dsatizabal/cpuy/caravel_board/hardware/breakout/_archive/caravel_breakout_QFN/gerbers/caravel_breakout_QFN-NPTH-drl_map.dxf

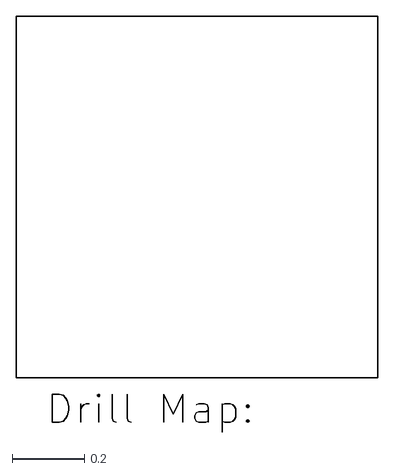
[picture p2: CAD file, 2025-09-26, an earlier design]
caravel_board/hardware/breakout/_archive/caravel_breakout_QFN/gerbers/caravel_breakout_QFN-NPTH-drl_map.dxf
1.00 x 1.15
