dsatizabal/cpuy/caravel_board/hardware/breakout/_archive/caravel_breakout_v1/gerbers/Caravel_breakout-drl_map.dxf

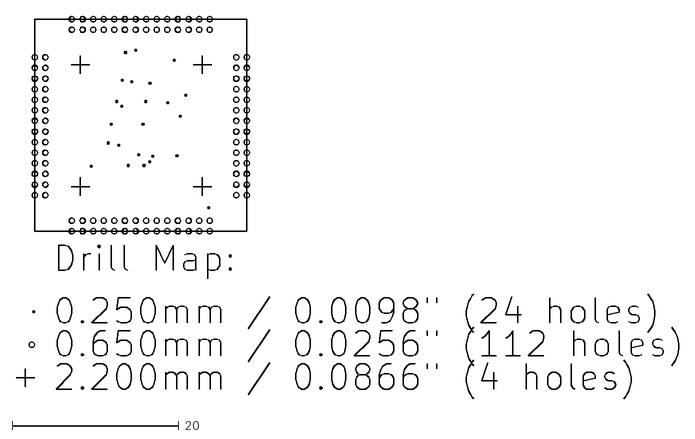
[picture p3: CAD file, 2025-09-26, an earlier design]
caravel_board/hardware/breakout/_archive/caravel_breakout_v1/gerbers/Caravel_breakout-drl_map.dxf
79.4 x 45.8
