dsatizabal/cpuy/caravel_board/hardware/breakout/_archive/caravel_breakout_v1/TC2030-IDC-NL/TC2030-IDC-NL.step

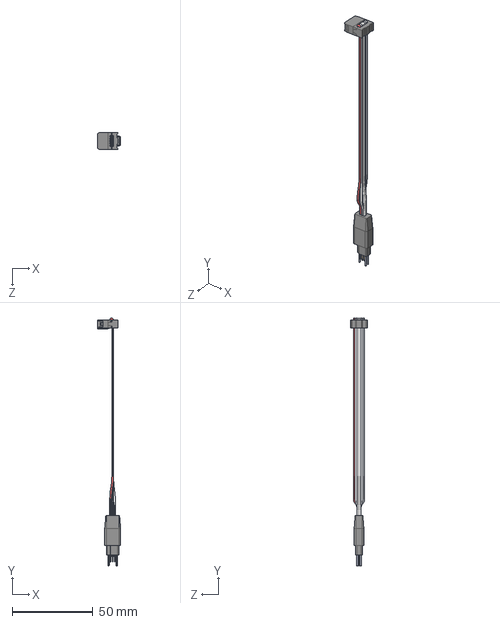
[picture p4: CAD file, 2025-09-26, an earlier design]
caravel_board/hardware/breakout/_archive/caravel_breakout_v1/TC2030-IDC-NL/TC2030-IDC-NL.step
14.5 x 153.6 x 10.7 mm
