dsatizabal/cpuy/caravel_board/hardware/breakout/_archive/caravel_breakout_QFN/gerbers/caravel_breakout_QFN-PTH-drl_map.dxf

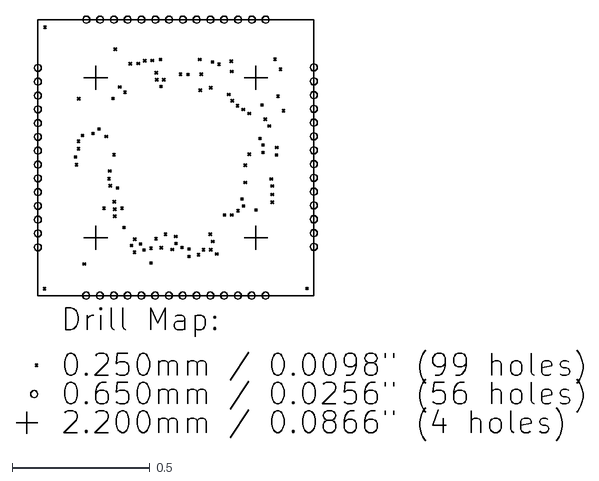
[picture p5: CAD file, 2025-09-26, an earlier design]
caravel_board/hardware/breakout/_archive/caravel_breakout_QFN/gerbers/caravel_breakout_QFN-PTH-drl_map.dxf
2.05 x 1.54
