dsatizabal/cpuy/verilog/instructions/Processor instructions set.xlsx

Type | Instruction | OpCode |  |  |  |  |  |  |  | Op1 |  |  |  |  |  |  |  | Op2 |  |  |  |  |  |  |  | Opcode DEC
Instructions with operands | MovMW | 1 | 0 | 0 | 0 | 0 | 0 | 0 | O | A | A | A | A | A | A | A | A | - | - | - | - | - | - | - | - | 128 - 129
 | MovWM | 1 | 0 | 0 | 0 | 0 | 0 | 1 | O | A | A | A | A | A | A | A | A | - | - | - | - | - | - | - | - | 130 - 131
 | MovLW | 1 | 0 | 0 | 0 | 0 | 1 | 0 | O | L | L | L | L | L | L | L | L | - | - | - | - | - | - | - | - | 132 - 133
 | MovLM | 1 | 0 | 0 | 0 | 0 | 1 | 1 | O | L | L | L | L | L | L | L | L | A | A | A | A | A | A | A | A | 134 - 135
 | AddLW | 1 | 0 | 0 | 0 | 1 | 0 | 0 | O | L | L | L | L | L | L | L | L | - | - | - | - | - | - | - | - | 136 - 137
 | AddMW | 1 | 0 | 0 | 0 | 1 | 0 | 1 | O | A | A | A | A | A | A | A | A | - | - | - | - | - | - | - | - | 138 - 139
 | SubLW | 1 | 0 | 0 | 0 | 1 | 1 | 0 | O | L | L | L | L | L | L | L | L | - | - | - | - | - | - | - | - | 140 - 141
 | SubMW | 1 | 0 | 0 | 0 | 1 | 1 | 1 | O | A | A | A | A | A | A | A | A | - | - | - | - | - | - | - | - | 142 - 143
 | MulLW | 1 | 0 | 0 | 1 | 0 | 0 | 0 | O | L | L | L | L | L | L | L | L | A | A | A | A | A | A | A | A | 144 - 145
 | MulMW | 1 | 0 | 0 | 1 | 0 | 0 | 1 | O | A1 | A1 | A1 | A1 | A1 | A1 | A1 | A1 | A2 | A2 | A2 | A2 | A2 | A2 | A2 | A2 | 146 - 147
 | AndLW | 1 | 0 | 0 | 1 | 0 | 1 | 0 | O | L | L | L | L | L | L | L | L | - | - | - | - | - | - | - | - | 148 - 149
 | AndMW | 1 | 0 | 0 | 1 | 0 | 1 | 1 | O | A | A | A | A | A | A | A | A | - | - | - | - | - | - | - | - | 150 - 151
 | OrLW | 1 | 0 | 0 | 1 | 1 | 0 | 0 | O | L | L | L | L | L | L | L | L | - | - | - | - | - | - | - | - | 152 - 153
 | OrMW | 1 | 0 | 0 | 1 | 1 | 0 | 1 | O | A | A | A | A | A | A | A | A | - | - | - | - | - | - | - | - | 154 - 155
 | XorLW | 1 | 0 | 0 | 1 | 1 | 1 | 0 | O | L | L | L | L | L | L | L | L | - | - | - | - | - | - | - | - | 156 - 157
 | XorMW | 1 | 0 | 0 | 1 | 1 | 1 | 1 | O | A | A | A | A | A | A | A | A | - | - | - | - | - | - | - | - | 158 - 159
 | XchWM | 1 | 0 | 1 | 0 | 0 | 0 | 0 | O | A | A | A | A | A | A | A | A | - | - | - | - | - | - | - | - | 160 - 161
 | Jmp | 1 | 0 | 1 | 0 | 0 | 0 | 1 | O | A | A | A | A | A | A | A | A | A | A | A | A | A | A | A | A | 162 - 163
 | JmpC | 1 | 0 | 1 | 0 | 0 | 1 | 0 | O | A | A | A | A | A | A | A | A | A | A | A | A | A | A | A | A | 164 - 165
 | JmpZ | 1 | 0 | 1 | 0 | 0 | 1 | 1 | O | A | A | A | A | A | A | A | A | A | A | A | A | A | A | A | A | 166 - 167
 | JmpS | 1 | 0 | 1 | 0 | 1 | 0 | 0 | O | A | A | A | A | A | A | A | A | A | A | A | A | A | A | A | A | 168 - 169
 | Call | 1 | 0 | 1 | 0 | 1 | 0 | 1 | O | A | A | A | A | A | A | A | A | A | A | A | A | A | A | A | A | 170 - 171
 | UNUSED | 1 | 0 | 1 | 0 | 1 | 1 | 0 | O | - | - | - | - | - | - | - | - | - | - | - | - | - | - | - | - | 172 - 173
 | UNUSED | 1 | 0 | 1 | 0 | 1 | 1 | 1 | O | - | - | - | - | - | - | - | - | - | - | - | - | - | - | - | - | 174 - 175
 | UNUSED | 1 | 0 | 1 | 1 | 0 | 0 | 0 | O | - | - | - | - | - | - | - | - | - | - | - | - | - | - | - | - | 176 - 177
 | UNUSED | 1 | 0 | 1 | 1 | 0 | 0 | 1 | O | - | - | - | - | - | - | - | - | - | - | - | - | - | - | - | - | 178 - 179
 | UNUSED | 1 | 0 | 1 | 1 | 0 | 1 | 0 | O | - | - | - | - | - | - | - | - | - | - | - | - | - | - | - | - | 180 - 181
 | UNUSED | 1 | 0 | 1 | 1 | 0 | 1 | 1 | O | - | - | - | - | - | - | - | - | - | - | - | - | - | - | - | - | 182 - 183
 | UNUSED | 1 | 0 | 1 | 1 | 1 | 0 | 0 | O | - | - | - | - | - | - | - | - | - | - | - | - | - | - | - | - | 184 - 185
 | UNUSED | 1 | 0 | 1 | 1 | 1 | 0 | 1 | O | - | - | - | - | - | - | - | - | - | - | - | - | - | - | - | - | 186 - 187
 | UNUSED | 1 | 0 | 1 | 1 | 1 | 1 | 0 | O | - | - | - | - | - | - | - | - | - | - | - | - | - | - | - | - | 188 - 189
 | UNUSED | 1 | 0 | 1 | 1 | 1 | 1 | 1 | O | - | - | - | - | - | - | - | - | - | - | - | - | - | - | - | - | 190 - 191
 | UNUSED | 1 | 1 | 0 | 0 | 0 | 0 | 0 | O | - | - | - | - | - | - | - | - | - | - | - | - | - | - | - | - | 192 - 193
 | UNUSED | 1 | 1 | 0 | 0 | 0 | 0 | 1 | O | - | - | - | - | - | - | - | - | - | - | - | - | - | - | - | - | 194 - 195
 | UNUSED | 1 | 1 | 0 | 0 | 0 | 1 | 0 | O | - | - | - | - | - | - | - | - | - | - | - | - | - | - | - | - | 196 - 197
 | UNUSED | 1 | 1 | 0 | 0 | 0 | 1 | 1 | O | - | - | - | - | - | - | - | - | - | - | - | - | - | - | - | - | 198 - 199
 | UNUSED | 1 | 1 | 0 | 0 | 1 | 0 | 0 | O | - | - | - | - | - | - | - | - | - | - | - | - | - | - | - | - | 200 - 201
 | UNUSED | 1 | 1 | 0 | 0 | 1 | 0 | 1 | O | - | - | - | - | - | - | - | - | - | - | - | - | - | - | - | - | 202 - 203
 | UNUSED | 1 | 1 | 0 | 0 | 1 | 1 | 0 | O | - | - | - | - | - | - | - | - | - | - | - | - | - | - | - | - | 204 - 205
 | UNUSED | 1 | 1 | 0 | 0 | 1 | 1 | 1 | O | - | - | - | - | - | - | - | - | - | - | - | - | - | - | - | - | 206 - 207
 | UNUSED | 1 | 1 | 0 | 1 | 0 | 0 | 0 | O | - | - | - | - | - | - | - | - | - | - | - | - | - | - | - | - | 208 - 209
 | UNUSED | 1 | 1 | 0 | 1 | 0 | 0 | 1 | O | - | - | - | - | - | - | - | - | - | - | - | - | - | - | - | - | 210 - 211
 | UNUSED | 1 | 1 | 0 | 1 | 0 | 1 | 0 | O | - | - | - | - | - | - | - | - | - | - | - | - | - | - | - | - | 212 - 213
 | UNUSED | 1 | 1 | 0 | 1 | 0 | 1 | 1 | O | - | - | - | - | - | - | - | - | - | - | - | - | - | - | - | - | 214 - 215
 | UNUSED | 1 | 1 | 0 | 1 | 1 | 0 | 0 | O | - | - | - | - | - | - | - | - | - | - | - | - | - | - | - | - | 216 - 217
 | UNUSED | 1 | 1 | 0 | 1 | 1 | 0 | 1 | O | - | - | - | - | - | - | - | - | - | - | - | - | - | - | - | - | 218 - 219
 | UNUSED | 1 | 1 | 0 | 1 | 1 | 1 | 0 | O | - | - | - | - | - | - | - | - | - | - | - | - | - | - | - | - | 220 - 221
 | UNUSED | 1 | 1 | 0 | 1 | 1 | 1 | 1 | O | - | - | - | - | - | - | - | - | - | - | - | - | - | - | - | - | 222 - 223
 | Tbjc (bit 0) | 1 | 1 | 1 | 0 | 0 | 0 | 0 | O | A | A | A | A | A | A | A | A | A | A | A | A | A | A | A | A | 224 - 225
 | Tbjc (bit 1) | 1 | 1 | 1 | 0 | 0 | 0 | 1 | O | A | A | A | A | A | A | A | A | A | A | A | A | A | A | A | A | 226 - 227
 | Tbjc (bit 2) | 1 | 1 | 1 | 0 | 0 | 1 | 0 | O | A | A | A | A | A | A | A | A | A | A | A | A | A | A | A | A | 228 - 229
 | Tbjc (bit 3) | 1 | 1 | 1 | 0 | 0 | 1 | 1 | O | A | A | A | A | A | A | A | A | A | A | A | A | A | A | A | A | 230 - 231
 | Tbjc (bit 4) | 1 | 1 | 1 | 0 | 1 | 0 | 0 | O | A | A | A | A | A | A | A | A | A | A | A | A | A | A | A | A | 232 - 233
 | Tbjc (bit 5) | 1 | 1 | 1 | 0 | 1 | 0 | 1 | O | A | A | A | A | A | A | A | A | A | A | A | A | A | A | A | A | 234 - 235
 | Tbjc (bit 6) | 1 | 1 | 1 | 0 | 1 | 1 | 0 | O | A | A | A | A | A | A | A | A | A | A | A | A | A | A | A | A | 236 - 237
 | Tbjc (bit 7) | 1 | 1 | 1 | 0 | 1 | 1 | 1 | O | A | A | A | A | A | A | A | A | A | A | A | A | A | A | A | A | 238 - 239
 | Tbjs (bit 0) | 1 | 1 | 1 | 1 | 0 | 0 | 0 | O | A | A | A | A | A | A | A | A | A | A | A | A | A | A | A | A | 240 - 241
 | Tbjs (bit 1) | 1 | 1 | 1 | 1 | 0 | 0 | 1 | O | A | A | A | A | A | A | A | A | A | A | A | A | A | A | A | A | 242 - 243
 | Tbjs (bit 2) | 1 | 1 | 1 | 1 | 0 | 1 | 0 | O | A | A | A | A | A | A | A | A | A | A | A | A | A | A | A | A | 244 - 245
 | Tbjs (bit 3) | 1 | 1 | 1 | 1 | 0 | 1 | 1 | O | A | A | A | A | A | A | A | A | A | A | A | A | A | A | A | A | 246 - 247
 | Tbjs (bit 4) | 1 | 1 | 1 | 1 | 1 | 0 | 0 | O | A | A | A | A | A | A | A | A | A | A | A | A | A | A | A | A | 248 - 249
 | Tbjs (bit 5) | 1 | 1 | 1 | 1 | 1 | 0 | 1 | O | A | A | A | A | A | A | A | A | A | A | A | A | A | A | A | A | 250 - 251
 | Tbjs (bit 6) | 1 | 1 | 1 | 1 | 1 | 1 | 0 | O | A | A | A | A | A | A | A | A | A | A | A | A | A | A | A | A | 252 - 253
 | Tbjs (bit 7) | 1 | 1 | 1 | 1 | 1 | 1 | 1 | O | A | A | A | A | A | A | A | A | A | A | A | A | A | A | A | A | 254 - 255
Instructions without operands | NOP | 0 | 0 | 0 | 0 | 0 | 0 | 0 | 0 | - | - | - | - | - | - | - | - | - | - | - | - | - | - | - | - | 0
 | Dec | 0 | 0 | 0 | 0 | 0 | 0 | 0 | 1 | - | - | - | - | - | - | - | - | - | - | - | - | - | - | - | - | 1
 | Inc | 0 | 0 | 0 | 0 | 0 | 0 | 1 | 0 | - | - | - | - | - | - | - | - | - | - | - | - | - | - | - | - | 2
 | Not | 0 | 0 | 0 | 0 | 0 | 0 | 1 | 1 | - | - | - | - | - | - | - | - | - | - | - | - | - | - | - | - | 3
 | SetC | 0 | 0 | 0 | 0 | 0 | 1 | 0 | 0 | - | - | - | - | - | - | - | - | - | - | - | - | - | - | - | - | 4
 | ClrC | 0 | 0 | 0 | 0 | 0 | 1 | 0 | 1 | - | - | - | - | - | - | - | - | - | - | - | - | - | - | - | - | 5
 | RL | 0 | 0 | 0 | 0 | 0 | 1 | 1 | 0 | - | - | - | - | - | - | - | - | - | - | - | - | - | - | - | - | 6
 | RR | 0 | 0 | 0 | 0 | 0 | 1 | 1 | 1 | - | - | - | - | - | - | - | - | - | - | - | - | - | - | - | - | 7
 | RLC | 0 | 0 | 0 | 0 | 1 | 0 | 0 | 0 | - | - | - | - | - | - | - | - | - | - | - | - | - | - | - | - | 8
 | RRC | 0 | 0 | 0 | 0 | 1 | 0 | 0 | 1 | - | - | - | - | - | - | - | - | - | - | - | - | - | - | - | - | 9
 | Swap | 0 | 0 | 0 | 0 | 1 | 0 | 1 | 0 | - | - | - | - | - | - | - | - | - | - | - | - | - | - | - | - | 10
 | UNUSED | 0 | 0 | 0 | 0 | 1 | 0 | 1 | 1 | - | - | - | - | - | - | - | - | - | - | - | - | - | - | - | - | 11
 | UNUSED | 0 | 0 | 0 | 0 | 1 | 1 | 0 | 0 | - | - | - | - | - | - | - | - | - | - | - | - | - | - | - | - | 12
 | UNUSED | 0 | 0 | 0 | 0 | 1 | 1 | 0 | 1 | - | - | - | - | - | - | - | - | - | - | - | - | - | - | - | - | 13
 | UNUSED | 0 | 0 | 0 | 0 | 1 | 1 | 1 | 0 | - | - | - | - | - | - | - | - | - | - | - | - | - | - | - | - | 14
 | UNUSED | 0 | 0 | 0 | 0 | 1 | 1 | 1 | 1 | - | - | - | - | - | - | - | - | - | - | - | - | - | - | - | - | 15
 | UNUSED | 0 | 0 | 0 | 1 | 0 | 0 | 0 | 0 | - | - | - | - | - | - | - | - | - | - | - | - | - | - | - | - | 16
 | UNUSED | 0 | 0 | 0 | 1 | 0 | 0 | 0 | 1 | - | - | - | - | - | - | - | - | - | - | - | - | - | - | - | - | 17
 | UNUSED | 0 | 0 | 0 | 1 | 0 | 0 | 1 | 0 | - | - | - | - | - | - | - | - | - | - | - | - | - | - | - | - | 18
 | UNUSED | 0 | 0 | 0 | 1 | 0 | 0 | 1 | 1 | - | - | - | - | - | - | - | - | - | - | - | - | - | - | - | - | 19
 | UNUSED | 0 | 0 | 0 | 1 | 0 | 1 | 0 | 0 | - | - | - | - | - | - | - | - | - | - | - | - | - | - | - | - | 20
 | UNUSED | 0 | 0 | 0 | 1 | 0 | 1 | 0 | 1 | - | - | - | - | - | - | - | - | - | - | - | - | - | - | - | - | 21
 | UNUSED | 0 | 0 | 0 | 1 | 0 | 1 | 1 | 0 | - | - | - | - | - | - | - | - | - | - | - | - | - | - | - | - | 22
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
 | UNUSED | 0 | 1 | 1 | 1 | 1 | 1 | 1 | 0 | - | - | - | - | - | - | - | - | - | - | - | - | - | - | - | - | 126
 | UNUSED | 0 | 1 | 1 | 1 | 1 | 1 | 1 | 1 | - | - | - | - | - | - | - | - | - | - | - | - | - | - | - | - | 127
