dsatizabal/cpuy/docs/cpuy-diagram-1.pdf

# top_design_mux mux control

LA

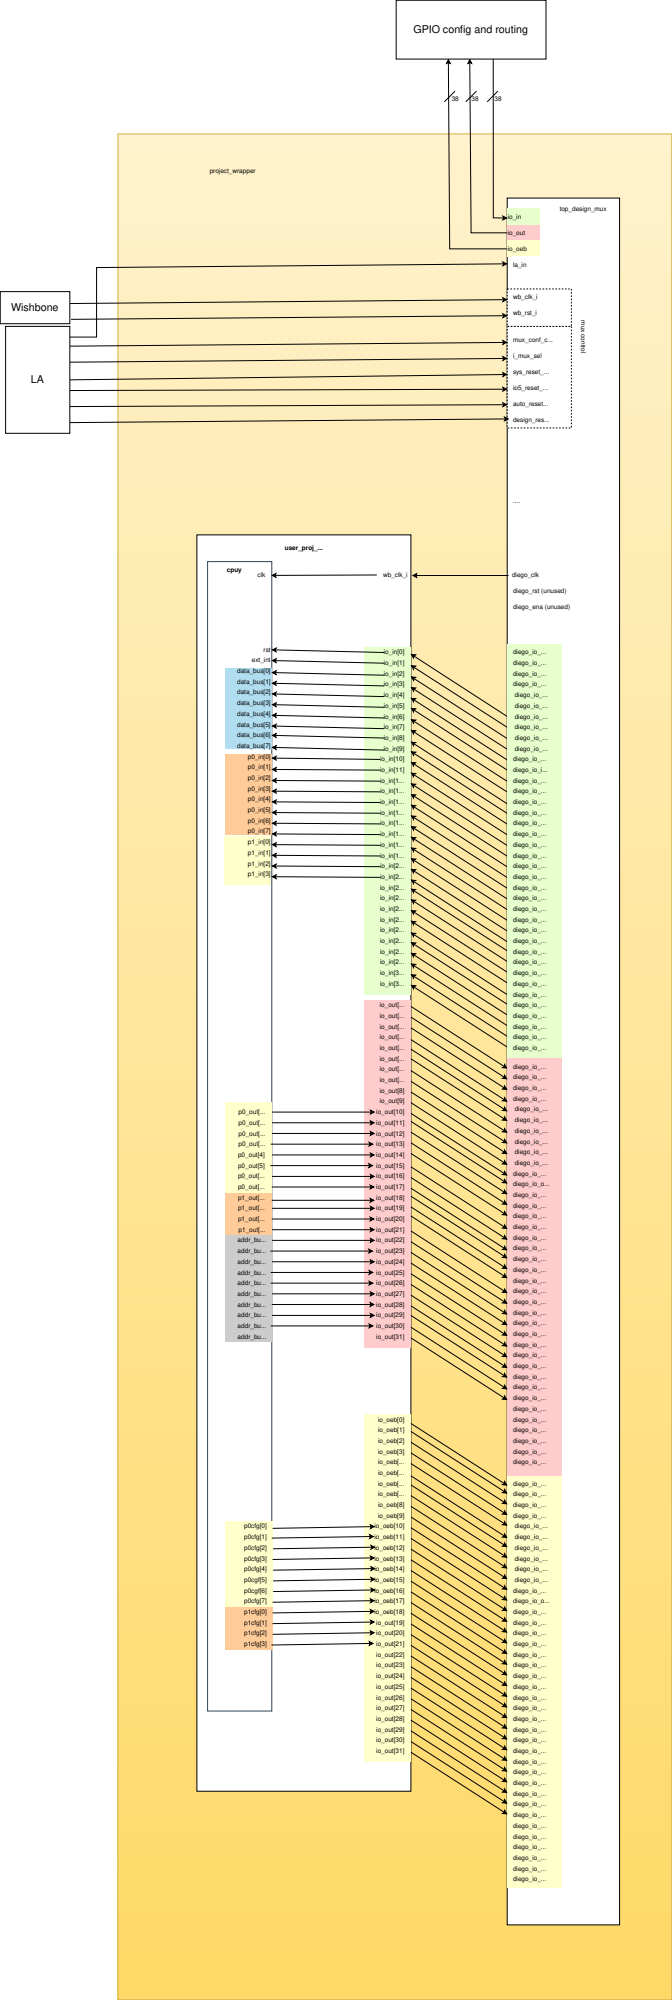
[picture p6: page 1]
io_out; io_oeb; diego_clk; diego_rst (unused); clk; wb_clk_i; ext_int; data_bus[0]; cpuy; user_proj_...; project_wrapper; design_res...; auto_reset...; io5_reset_...; sys_reset_...; i_mux_sel; mux_conf_c...; rst; data_bus[1]; data_bus[2]; data_bus[3]; data_bus[4]; data_bus[5]; data_bus[6]; data_bus[7]; io_out[...; io_out[8]; io_out[9]; io_out[10]; io_out[11]; io_out[12]; io_out[13]; io_out[14]; io_out[15]; io_out[16]; io_out[17]; io_out[18]; io_out[19]; io_out[20]; io_out[21]; io_out[22]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

GPIO config and routing
