dsatizabal/cpuy/docs/cpuy-diagram-2.pdf

# ROM

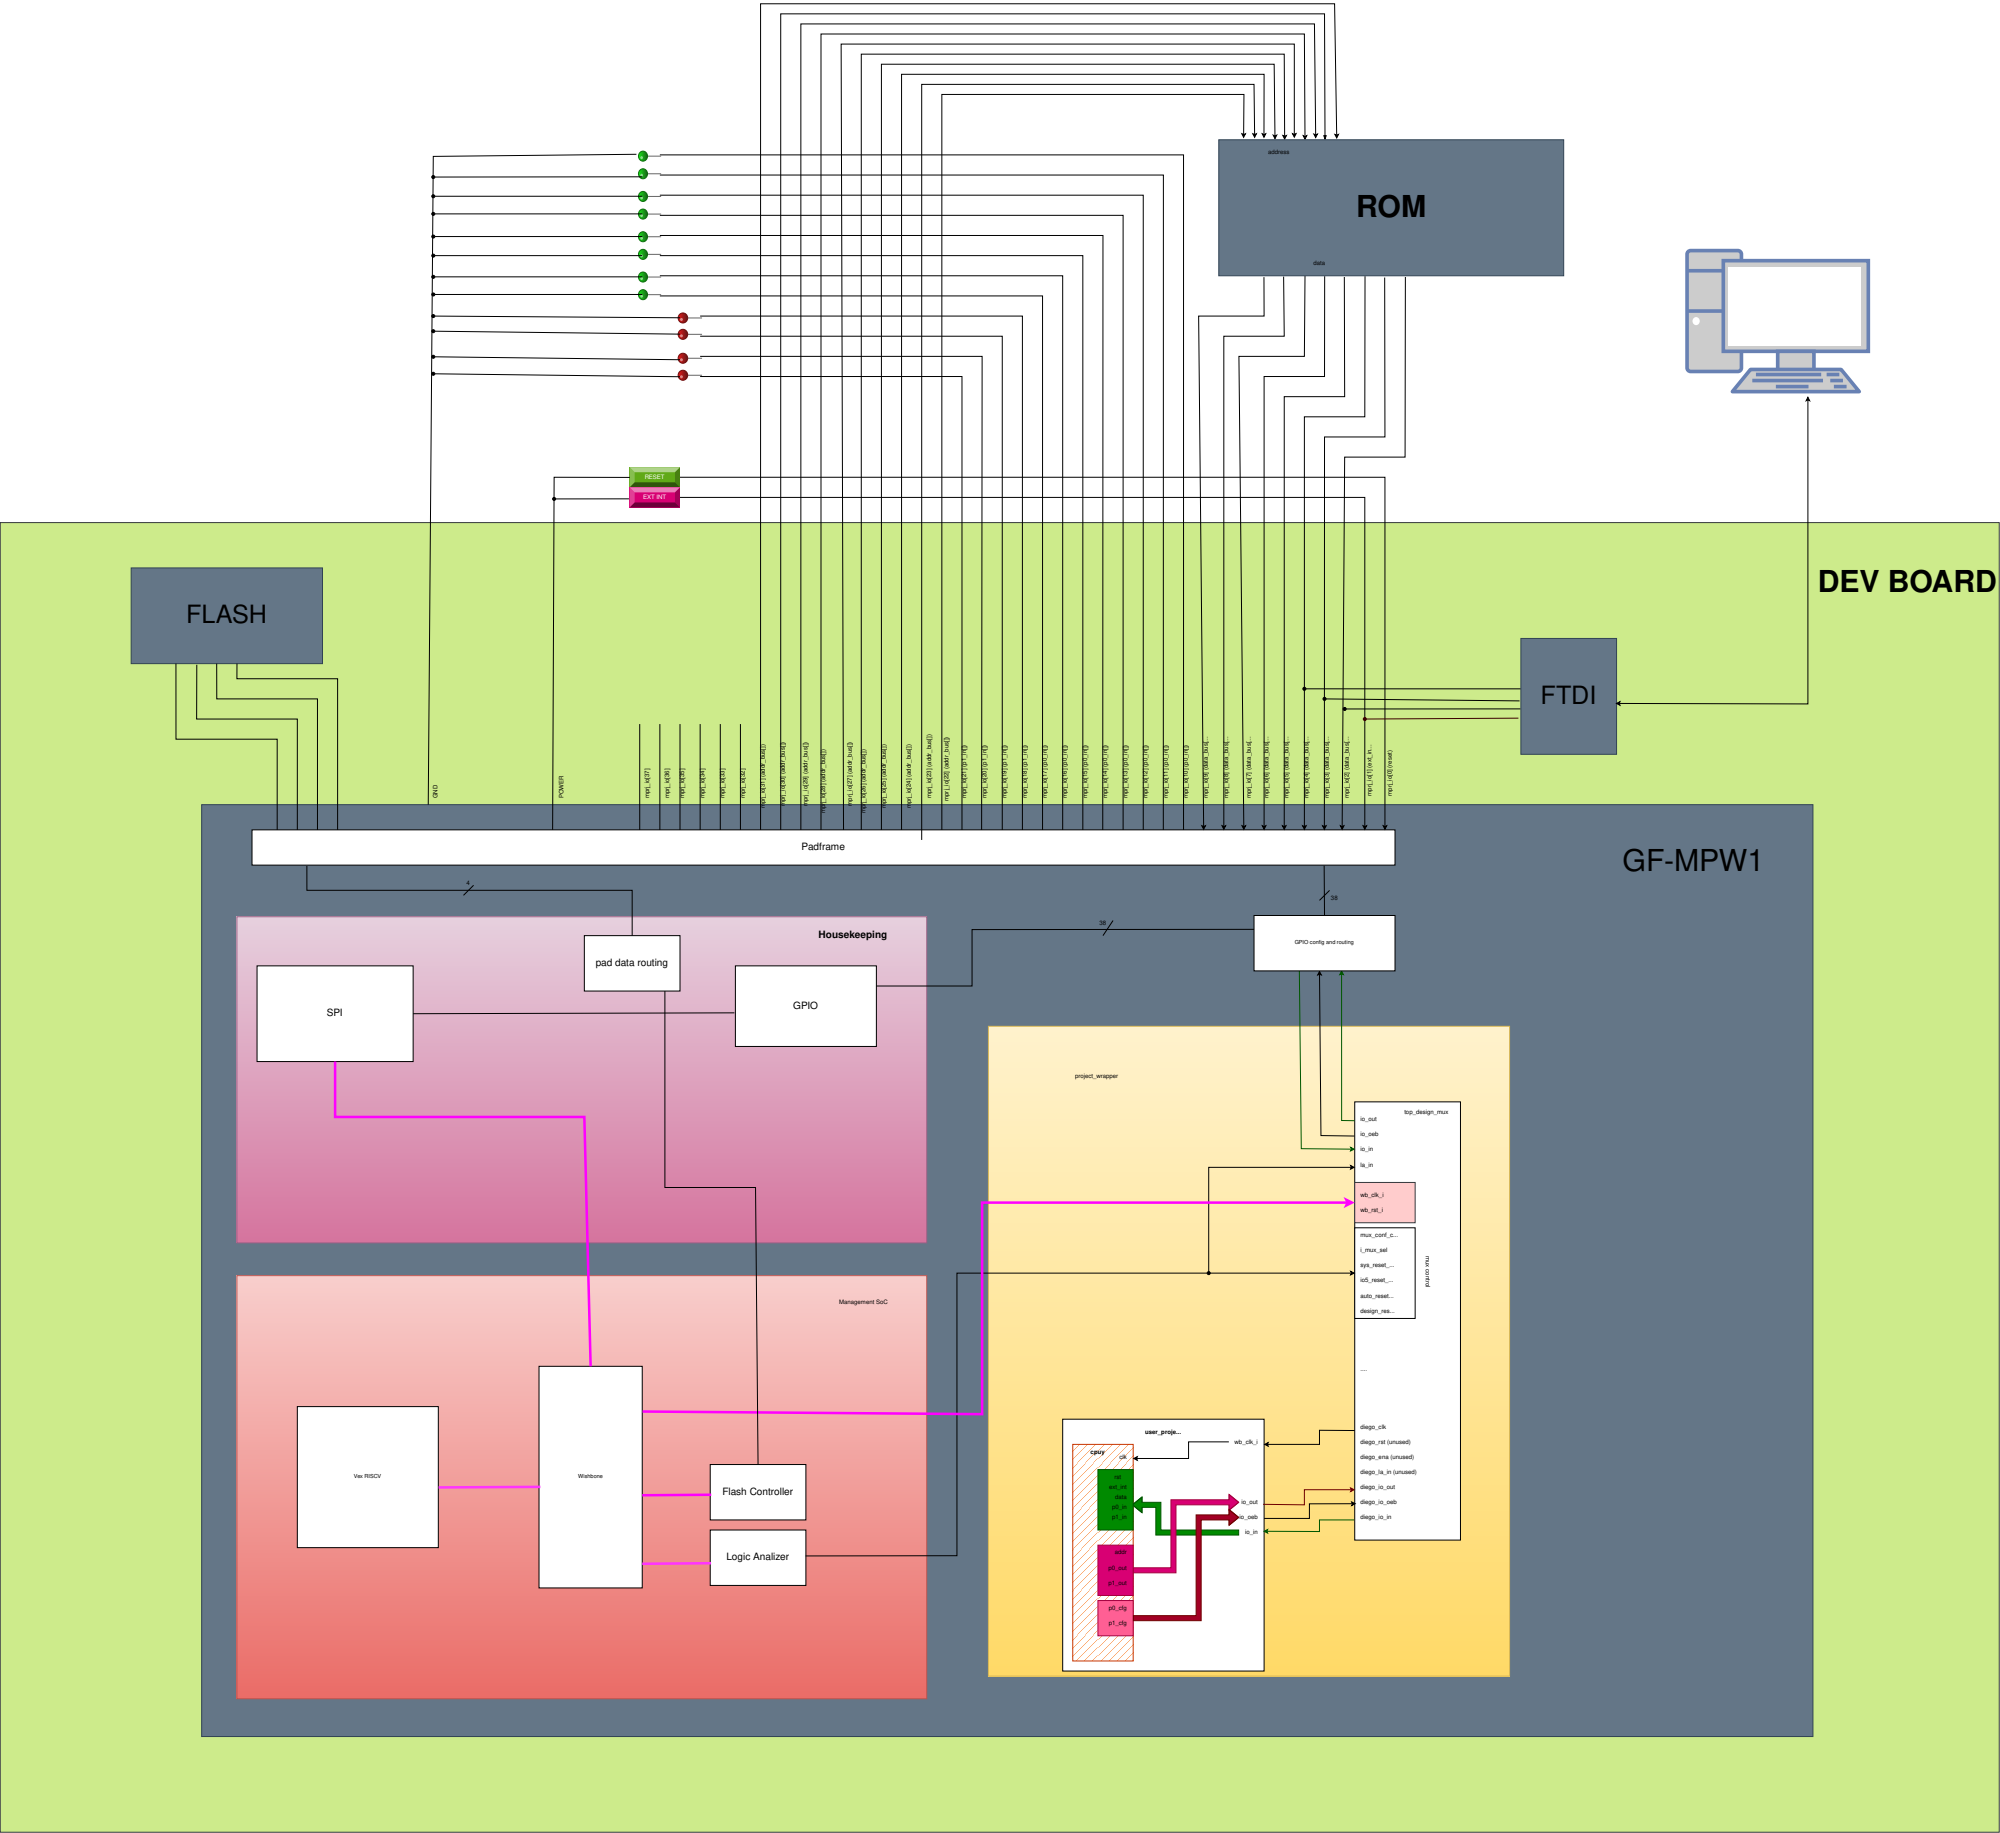
[picture p7: page 1]
io_out; io_oeb; diego_clk; diego_rst (unused); diego_ena (unused); diego_io_out; diego_io_oeb; diego_io_in; diego_la_in (unused); wb_clk_i; clk; ext_int; data; addr; p0_out; p1_out; p0_cfg; p1_cfg; cpuy; user_proje...; project_wrapper; Padframe; design_res...; auto_reset...; io5_reset_...; sys_reset_...; i_mux_sel; mux_conf_c...; wb_rst_i; Logic Analizer; top_design_mux mux control; Vex RISCV; Wishbone; Management SoC; mprj_io[1] (ext_in...; mprj_io[0] (reset); GF-MPW1; mprj_io[21] (p1_in[])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

GPIO config and routing

pad data routing
