dsatizabal/cpuy/caravel_board/hardware/development/caravel-dev-v5-M.2/caravel-dev-v5-M.2.kicad_pcb

## KiCad design caravel_board/hardware/development/caravel-dev-v5-M.2/caravel-dev-v5-M.2.kicad_pcb (2025-09-26, last stored version)

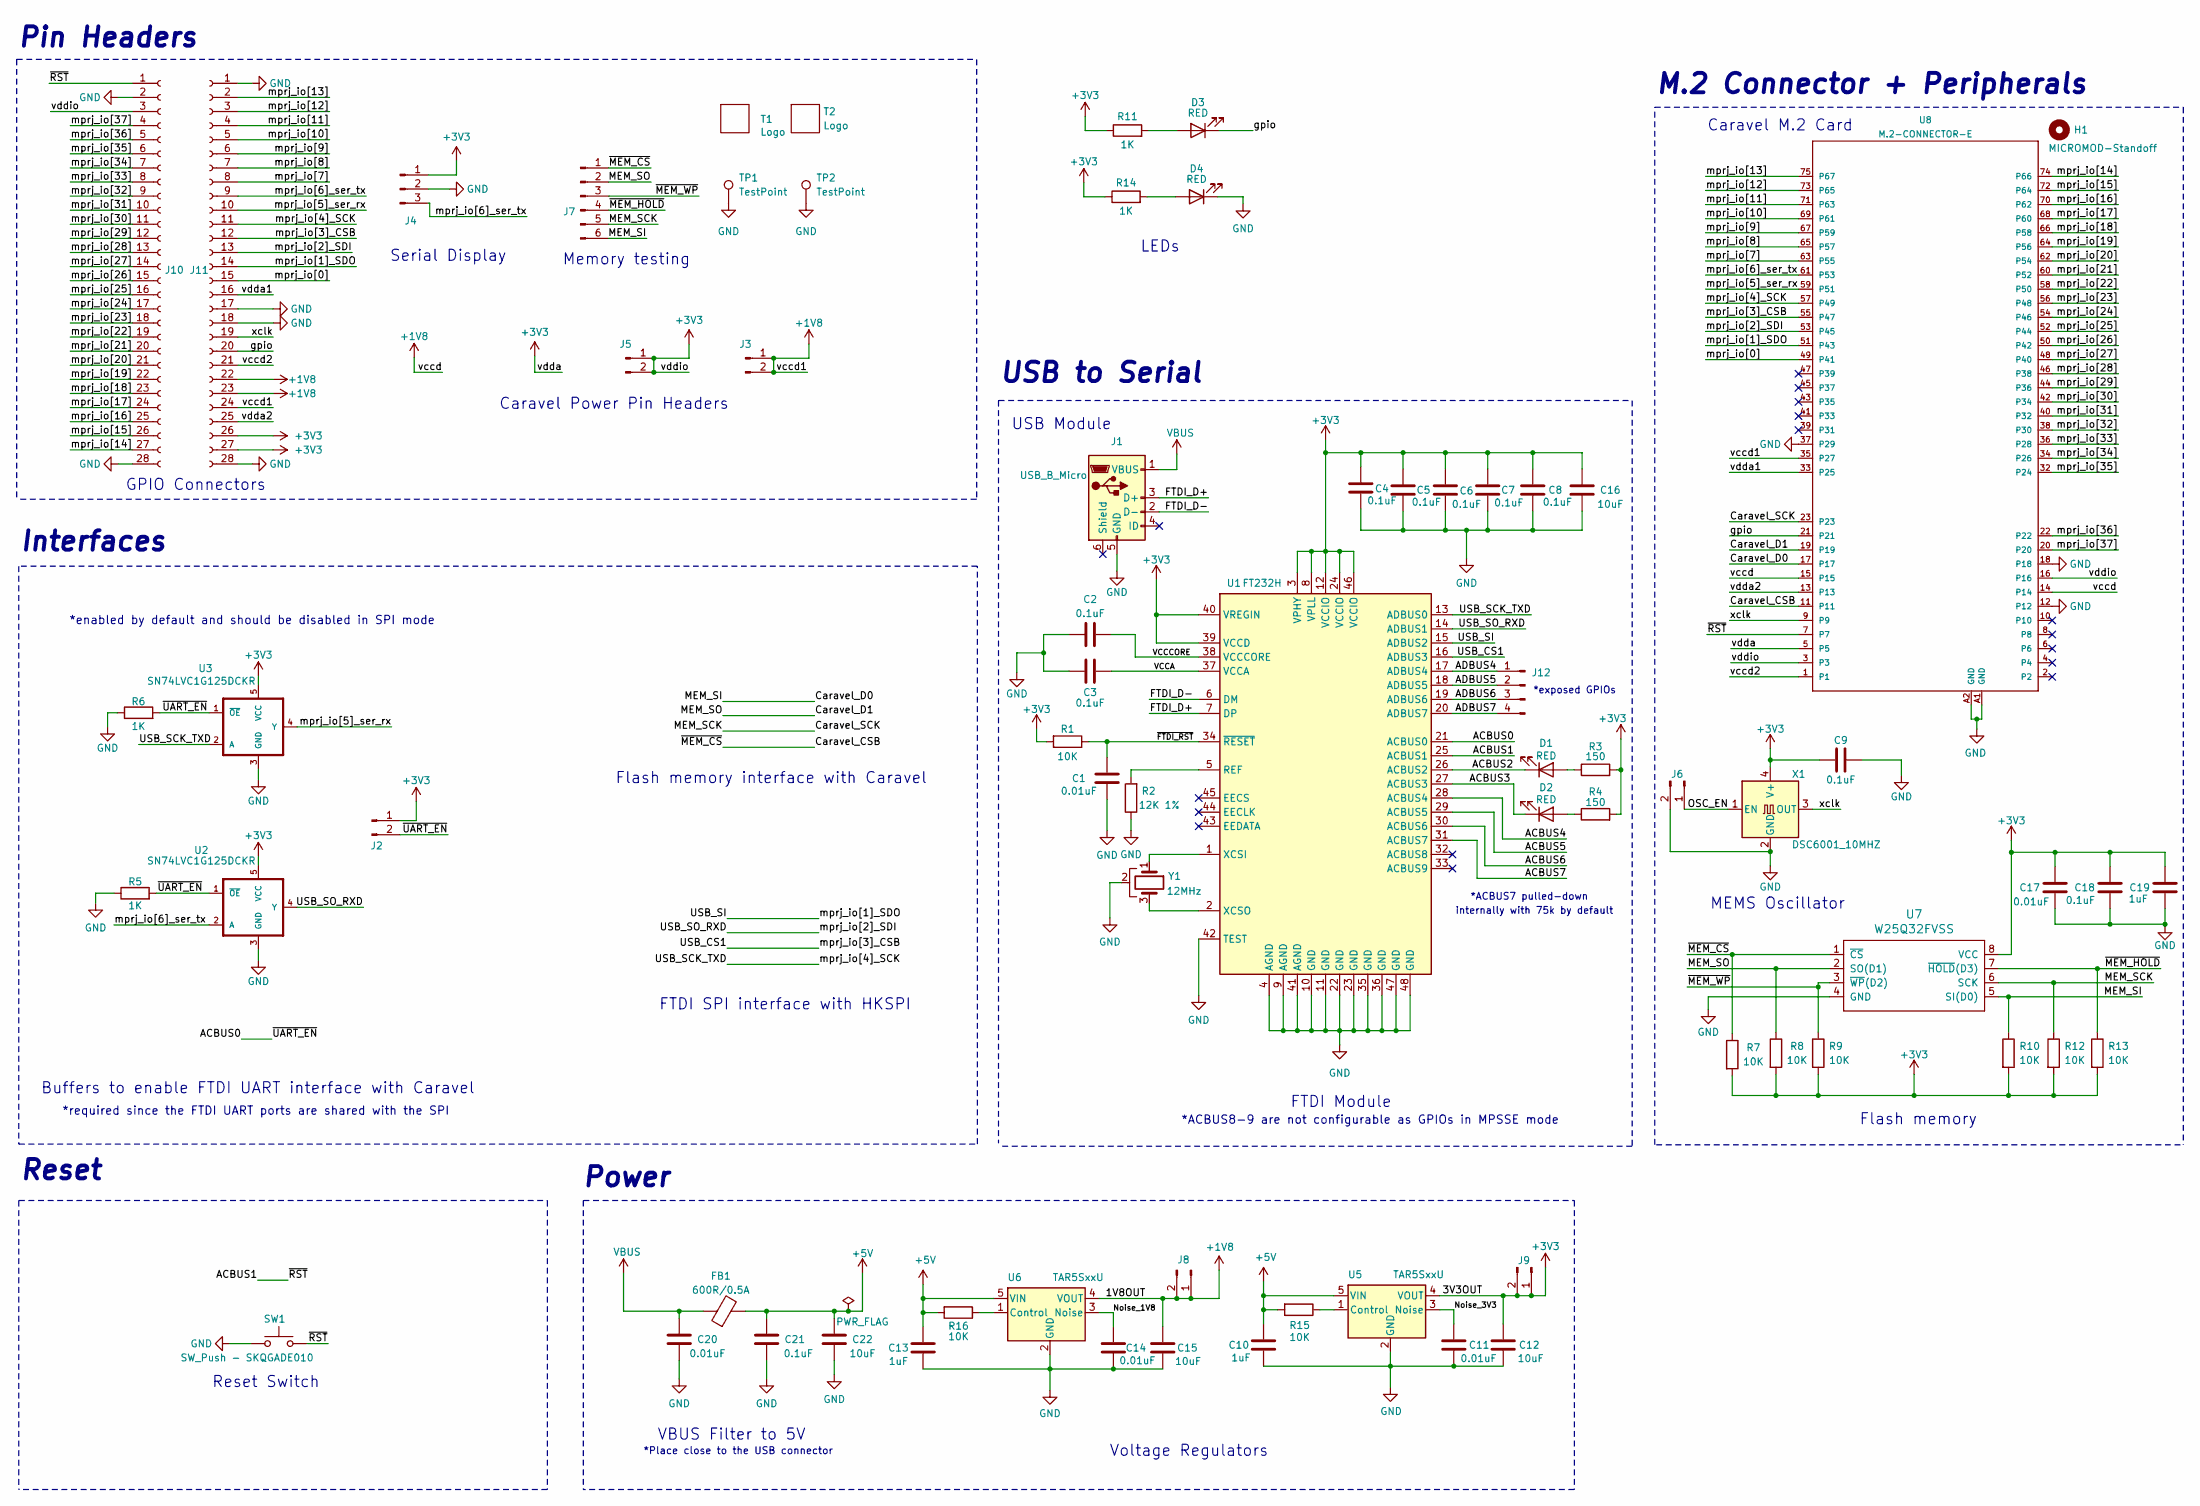
[picture p8: schematic caravel-dev-v5-M.2.kicad_sch, Caravel 3.3V Development Board]

Parts:
C1, C11, C14, C17, C20: 0.01uF; C_0805_2012Metric; Part # C0805C103K5RAC7411
C2, C3, C4, C5, C6, C7, C8, C9, C18, C21: 0.1uF; C_0805_2012Metric; Part # C0805C104K5RAC7411
C10, C13, C19: 1uF; C_0805_2012Metric; Part # 885012207103
C12, C15, C16, C22: 10uF; C_0805_2012Metric; Part # CL21B106KAYQNNE
D1, D2, D3, D4: RED; LED_1206_3216Metric; Part # LTST-C230KRKT
FB1: 600R/0.5A; L_0805_2012Metric; Part # 7427920415
H1: MICROMOD-Standoff; MicroMod-Standoff
J1: USB_B_Micro; FCI_10118193-0001LF; Part # 10118193-0001LF
J2, J3, J5, J6, J8, J9: Conn_01x02_Pin; PinHeader_1x02_P2.54mm_Vertical
J4: Conn_01x03_Pin; PinHeader_1x03_P2.54mm_Vertical
J7: Conn_01x06_Pin; PinHeader_1x06_P2.54mm_Vertical
J10, J11: Conn_01x28_Pin; PinHeader_1x28_P2.54mm_Vertical
J12: Conn_01x04_Pin; PinHeader_1x04_P2.54mm_Vertical
R1, R7, R8, R9, R10, R12, R13, R15, R16: 10K; R_0805_2012Metric; Part # RC0805FR-0710KL
R2: 12K 1%; R_0805_2012Metric; Part # RMCF0805FT12K0
R3, R4: 150; R_0805_2012Metric; Part # RNCP0805FTD150R
R5, R6, R11, R14: 1K; R_0805_2012Metric; Part # RC0805FR-071KL
SW1: SW_Push - SKQGADE010; SW4-SMD-5.2X5.2X1.5MM
T1: Logo; logo_large
T2: Logo; ef_logo_large
TP1, TP2: TestPoint; TestPoint_Bridge_Pitch2.54mm_Drill1.0mm
U1: FT232H; QFN-48-1EP_8x8mm_P0.5mm_EP6.2x6.2mm; Part # FT232H
U2, U3: SN74LVC1G125DCKR; SOT65P210X110-5N; Part # SN74LVC1G125DCKR
U5: TAR5SxxU; SOT-353F; Part # TAR5S33UTE85LF
U6: TAR5SxxU; SOT-353F; Part # TAR5S18U-TE85L-F
U7: W25Q32FVSS; SOIC127P790X216-8N; Part # W25Q32JVSSIQ
U8: M.2-CONNECTOR-E
X1: DSC6001_10MHZ; DSC6001JE1A-010.0000; Part # DSC6001JI1B
Y1: 12MHz; CSTNE12M0GH5L000R0; Part # CSTNE12M0GH5L000R0

Connections:
+1V8: C15.2, J3.1, J3.2, J8.1, J8.2, J11.22, J11.23, J11.24, U6.4 (VOUT), U8.14, U8.15, U8.35 (P27)
+3V3: C4.2, C5.2, C6.2, C7.2, C8.2, C9.2, C12.2, C16.1, C17.2, C18.1, C19.1, J2.1, J4.1, J5.1, J5.2, J9.1, J9.2, J10.3, J11.26, J11.27, R1.2, R3.2, R4.2, R7.2, R8.2, R9.2, R10.2, R11.1, R12.2, R13.2, R14.1, U1.3 (VPHY), U1.8 (VPLL), U1.12 (VCCIO), U1.24 (VCCIO), U1.39 (VCCD), U1.40 (VREGIN), U1.46 (VCCIO), U2.5 (VCC), U3.5 (VCC), U5.4 (VOUT), U7.8 (VCC), U8.3, U8.5, U8.16, X1.4 (V+)
+5V: C10.2, C13.2, C21.2, C22.2, FB1.2, R15.2, R16.2, U5.5 (VIN), U6.5 (VIN)
/ACBUS0: J2.2, R5.2, R6.2, U1.21 (ACBUS0), U2.1 (~OE), U3.1 (~OE)
/ACBUS1: J10.1, SW1.1, U1.25 (ACBUS1), U8.7
/ACBUS2: D1.1 (K), U1.26 (ACBUS2)
/ACBUS3: D2.1 (K), U1.27 (ACBUS3)
/ACBUS4: U1.28 (ACBUS4)
/ACBUS5: U1.29 (ACBUS5)
/ACBUS6: U1.30 (ACBUS6)
/ACBUS7: U1.31 (ACBUS7)
/ADBUS4: J12.1, U1.17 (ADBUS4)
/ADBUS5: J12.2, U1.18 (ADBUS5)
/ADBUS6: J12.3, U1.19 (ADBUS6)
/ADBUS7: J12.4, U1.20 (ADBUS7)
/Caravel_CSB: J7.1, R7.1, U7.1 (~CS), U8.11
/Caravel_D0: J7.6, R10.1, U7.5 (SI(D0)), U8.17
/Caravel_D1: J7.2, R8.1, U7.2 (SO(D1)), U8.19
/Caravel_SCK: J7.5, R12.1, U7.6 (SCK), U8.23
/FTDI_D+: J1.3 (D+), U1.7 (DP)
/FTDI_D-: J1.2 (D-), U1.6 (DM)
/Noise_1V8: C14.1, U6.3 (Noise)
/Noise_3V3: C11.1, U5.3 (Noise)
/OSC_EN: J6.1, X1.1 (EN)
/USB_CS1: J11.12, U1.16 (ADBUS3), U8.55 (P47)
/USB_SCK_TXD: J11.11, U1.13 (ADBUS0), U3.2 (A), U8.57 (P49)
/USB_SI: J11.14, U1.15 (ADBUS2), U8.51 (P43)
/USB_SO_RXD: J11.13, U1.14 (ADBUS1), U2.4 (Y), U8.53 (P45)
/VCCA: C3.2, U1.37 (VCCA)
/VCCCORE: C2.2, U1.38 (VCCCORE)
/gpio: D3.1 (K), J11.20, U8.21
/mprj_io[0]: J11.15, U8.49 (P41)
/mprj_io[5]_ser_rx: J11.10, U3.4 (Y), U8.59 (P51)
/mprj_io[6]_ser_tx: J4.3, J11.9, U2.2 (A), U8.61 (P53)
/mprj_io[7]: J11.8, U8.63 (P55)
/mprj_io[8]: J11.7, U8.65 (P57)
/mprj_io[9]: J11.6, U8.67 (P59)
/mprj_io[10]: J11.5, U8.69 (P61)
/mprj_io[11]: J11.4, U8.71 (P63)
/mprj_io[12]: J11.3, U8.73 (P65)
/mprj_io[13]: J11.2, U8.75 (P67)
/mprj_io[14]: J10.27, U8.74 (P66)
/mprj_io[15]: J10.26, U8.72 (P64)
/mprj_io[16]: J10.25, U8.70 (P62)
/mprj_io[17]: J10.24, U8.68 (P60)
/mprj_io[18]: J10.23, U8.66 (P58)
/mprj_io[19]: J10.22, U8.64 (P56)
/mprj_io[20]: J10.21, U8.62 (P54)
/mprj_io[21]: J10.20, U8.60 (P52)
/mprj_io[22]: J10.19, U8.58 (P50)
/mprj_io[23]: J10.18, U8.56 (P48)
/mprj_io[24]: J10.17, U8.54 (P46)
/mprj_io[25]: J10.16, U8.52 (P44)
/mprj_io[26]: J10.15, U8.50 (P42)
/mprj_io[27]: J10.14, U8.48 (P40)
/mprj_io[28]: J10.13, U8.46 (P38)
/mprj_io[29]: J10.12, U8.44 (P36)
/mprj_io[30]: J10.11, U8.42 (P34)
/mprj_io[31]: J10.10, U8.40 (P32)
/mprj_io[32]: J10.9, U8.38 (P30)
/mprj_io[33]: J10.8, U8.36 (P28)
/mprj_io[34]: J10.7, U8.34 (P26)
/mprj_io[35]: J10.6, U8.32 (P24)
/mprj_io[36]: J10.5, U8.22
/mprj_io[37]: J10.4, U8.20
/vccd2: J11.21, U8.1
/vdda1: J11.16, U8.33 (P25)
/vdda2: J11.25, U8.13
/xclk: J11.19, U8.9, X1.3 (OUT)
/~FTDI_RST: C1.2, R1.1, U1.34 (~RESET)
/~MEM_HOLD: J7.4, R13.1, U7.7 (~HOLD(D3))
/~MEM_WP: J7.3, R9.1, U7.3 (~WP(D2))
GND: C1.1, C2.1, C3.1, C4.1, C5.1, C6.1, C7.1, C8.1, C9.1, C10.1, C11.2, C12.1, C13.1, C14.2, C15.1, C16.2, C17.1, C18.2, C19.2, C20.2, C21.1, C22.1, D4.1 (K), J1.5 (GND), J4.2, J6.2, J10.2, J10.28, J11.1, J11.17, J11.18, J11.28, R2.1, R5.1, R6.1, SW1.2, TP1.1, TP2.1, U1.4 (AGND), U1.9 (AGND), U1.10 (GND), U1.11 (GND), U1.22 (GND), U1.23 (GND), U1.35 (GND), U1.36 (GND), U1.41 (AGND), U1.42 (TEST), U1.47 (GND), U1.48 (GND), U2.3 (GND), U3.3 (GND), U5.2 (GND), U6.2 (GND), U7.4 (GND), U8.12, U8.18, U8.37 (P29), U8.A1 (GND), U8.A2 (GND), X1.2 (GND), Y1.2
unnamed: D1.2 (A), R3.1
unnamed: D2.2 (A), R4.1
unnamed: D3.2 (A), R11.2
unnamed: D4.2 (A), R14.2
unnamed: R2.2, U1.5 (REF)
unnamed: U1.1 (XCSI), Y1.1
unnamed: U1.2 (XCSO), Y1.3
unnamed: R15.1, U5.1 (Control)
unnamed: R16.1, U6.1 (Control)
VBUS: C20.1, FB1.1, J1.1 (VBUS)

Notes on the sheet:
USB to Serial
USB Module
MEMS Oscillator
*Place close to the USB connector
Flash memory interface with Caravel
Caravel Power Pin Headers
GPIO Connectors
*required since the FTDI UART ports are shared with the SPI
LEDs
Flash memory
Serial Display
Buffers to enable FTDI UART interface with Caravel
M.2 Connector + Peripherals
*enabled by default and should be disabled in SPI mode
*exposed GPIOs
Power
Pin Headers
VBUS Filter to 5V
Interfaces
Voltage Regulators
*ACBUS8-9 are not configurable as GPIOs in MPSSE mode
Reset Switch
Memory testing
*ACBUS7 pulled-down
internally with 75k by default
FTDI SPI interface with HKSPI
FTDI Module
Reset
Caravel M.2 Card

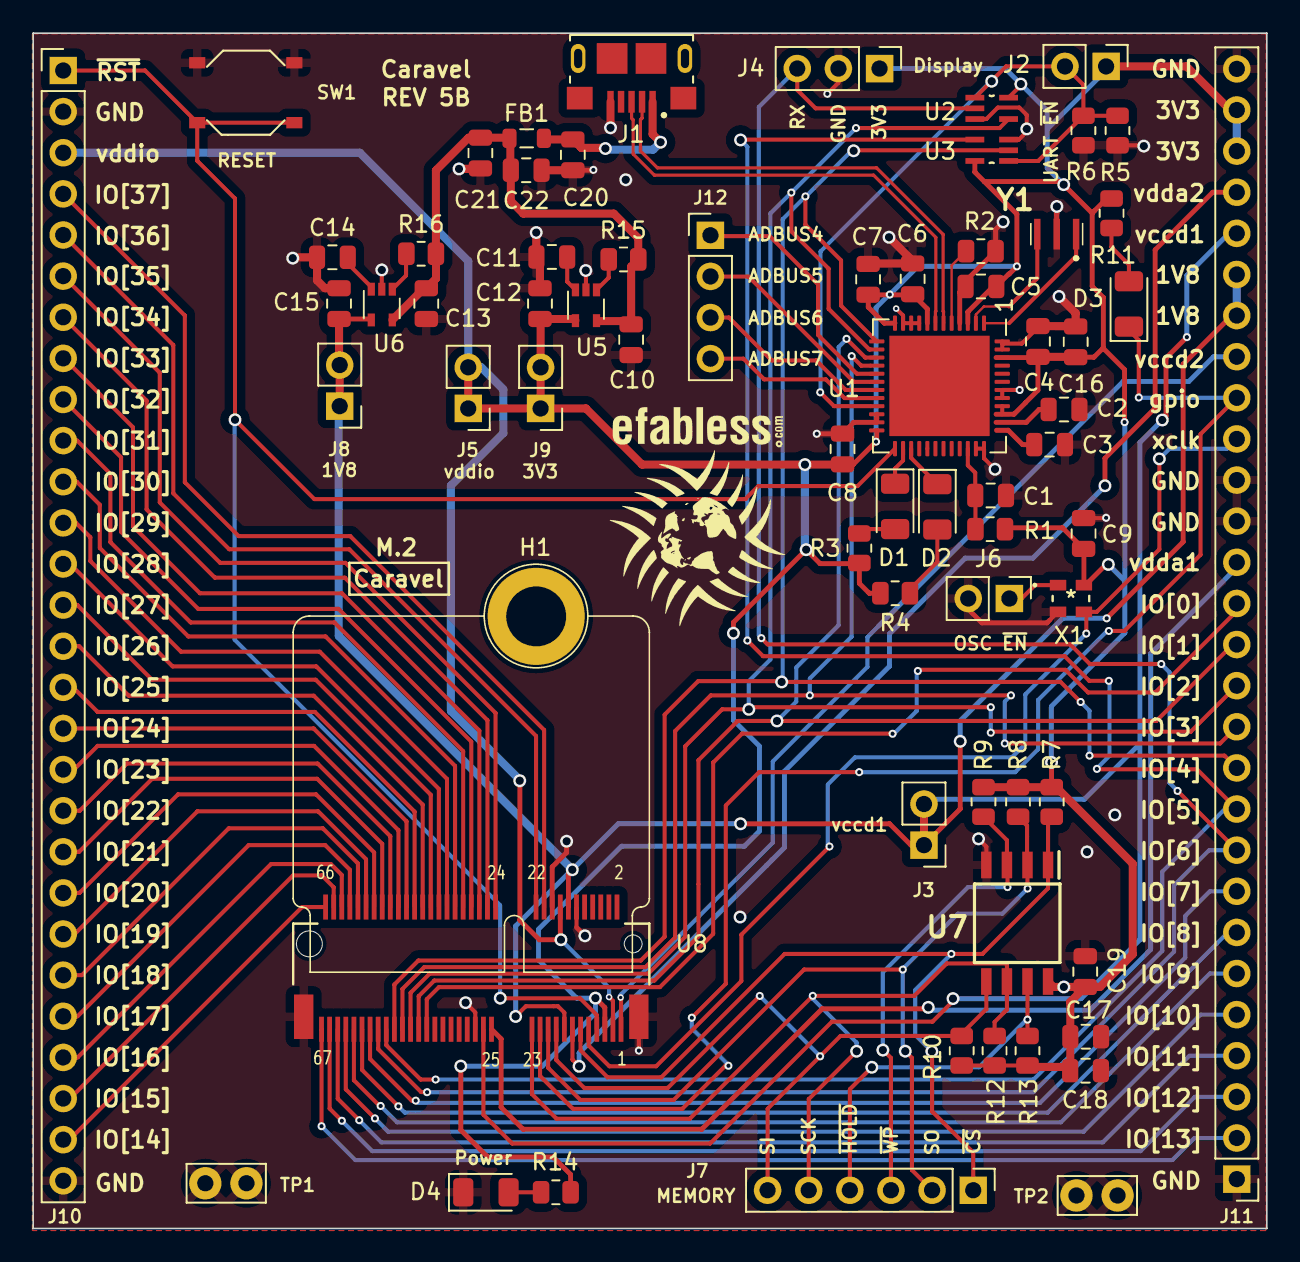
[picture p9: board caravel-dev-v5-M.2.kicad_pcb from above]

Board: 2 copper layers, 76.2 x 73.8 mm, 70 parts (0 on the bottom side), 79 nets.
