dsatizabal/cpuy/caravel_board/hardware/development/_archive/caravel_pcb_v4_FTDI/caravel_pcb_v4_FTDI_flexy.kicad_pcb

## KiCad design caravel_board/hardware/development/_archive/caravel_pcb_v4_FTDI/caravel_pcb_v4_FTDI_flexy.kicad_pcb (2025-09-26, an earlier design)

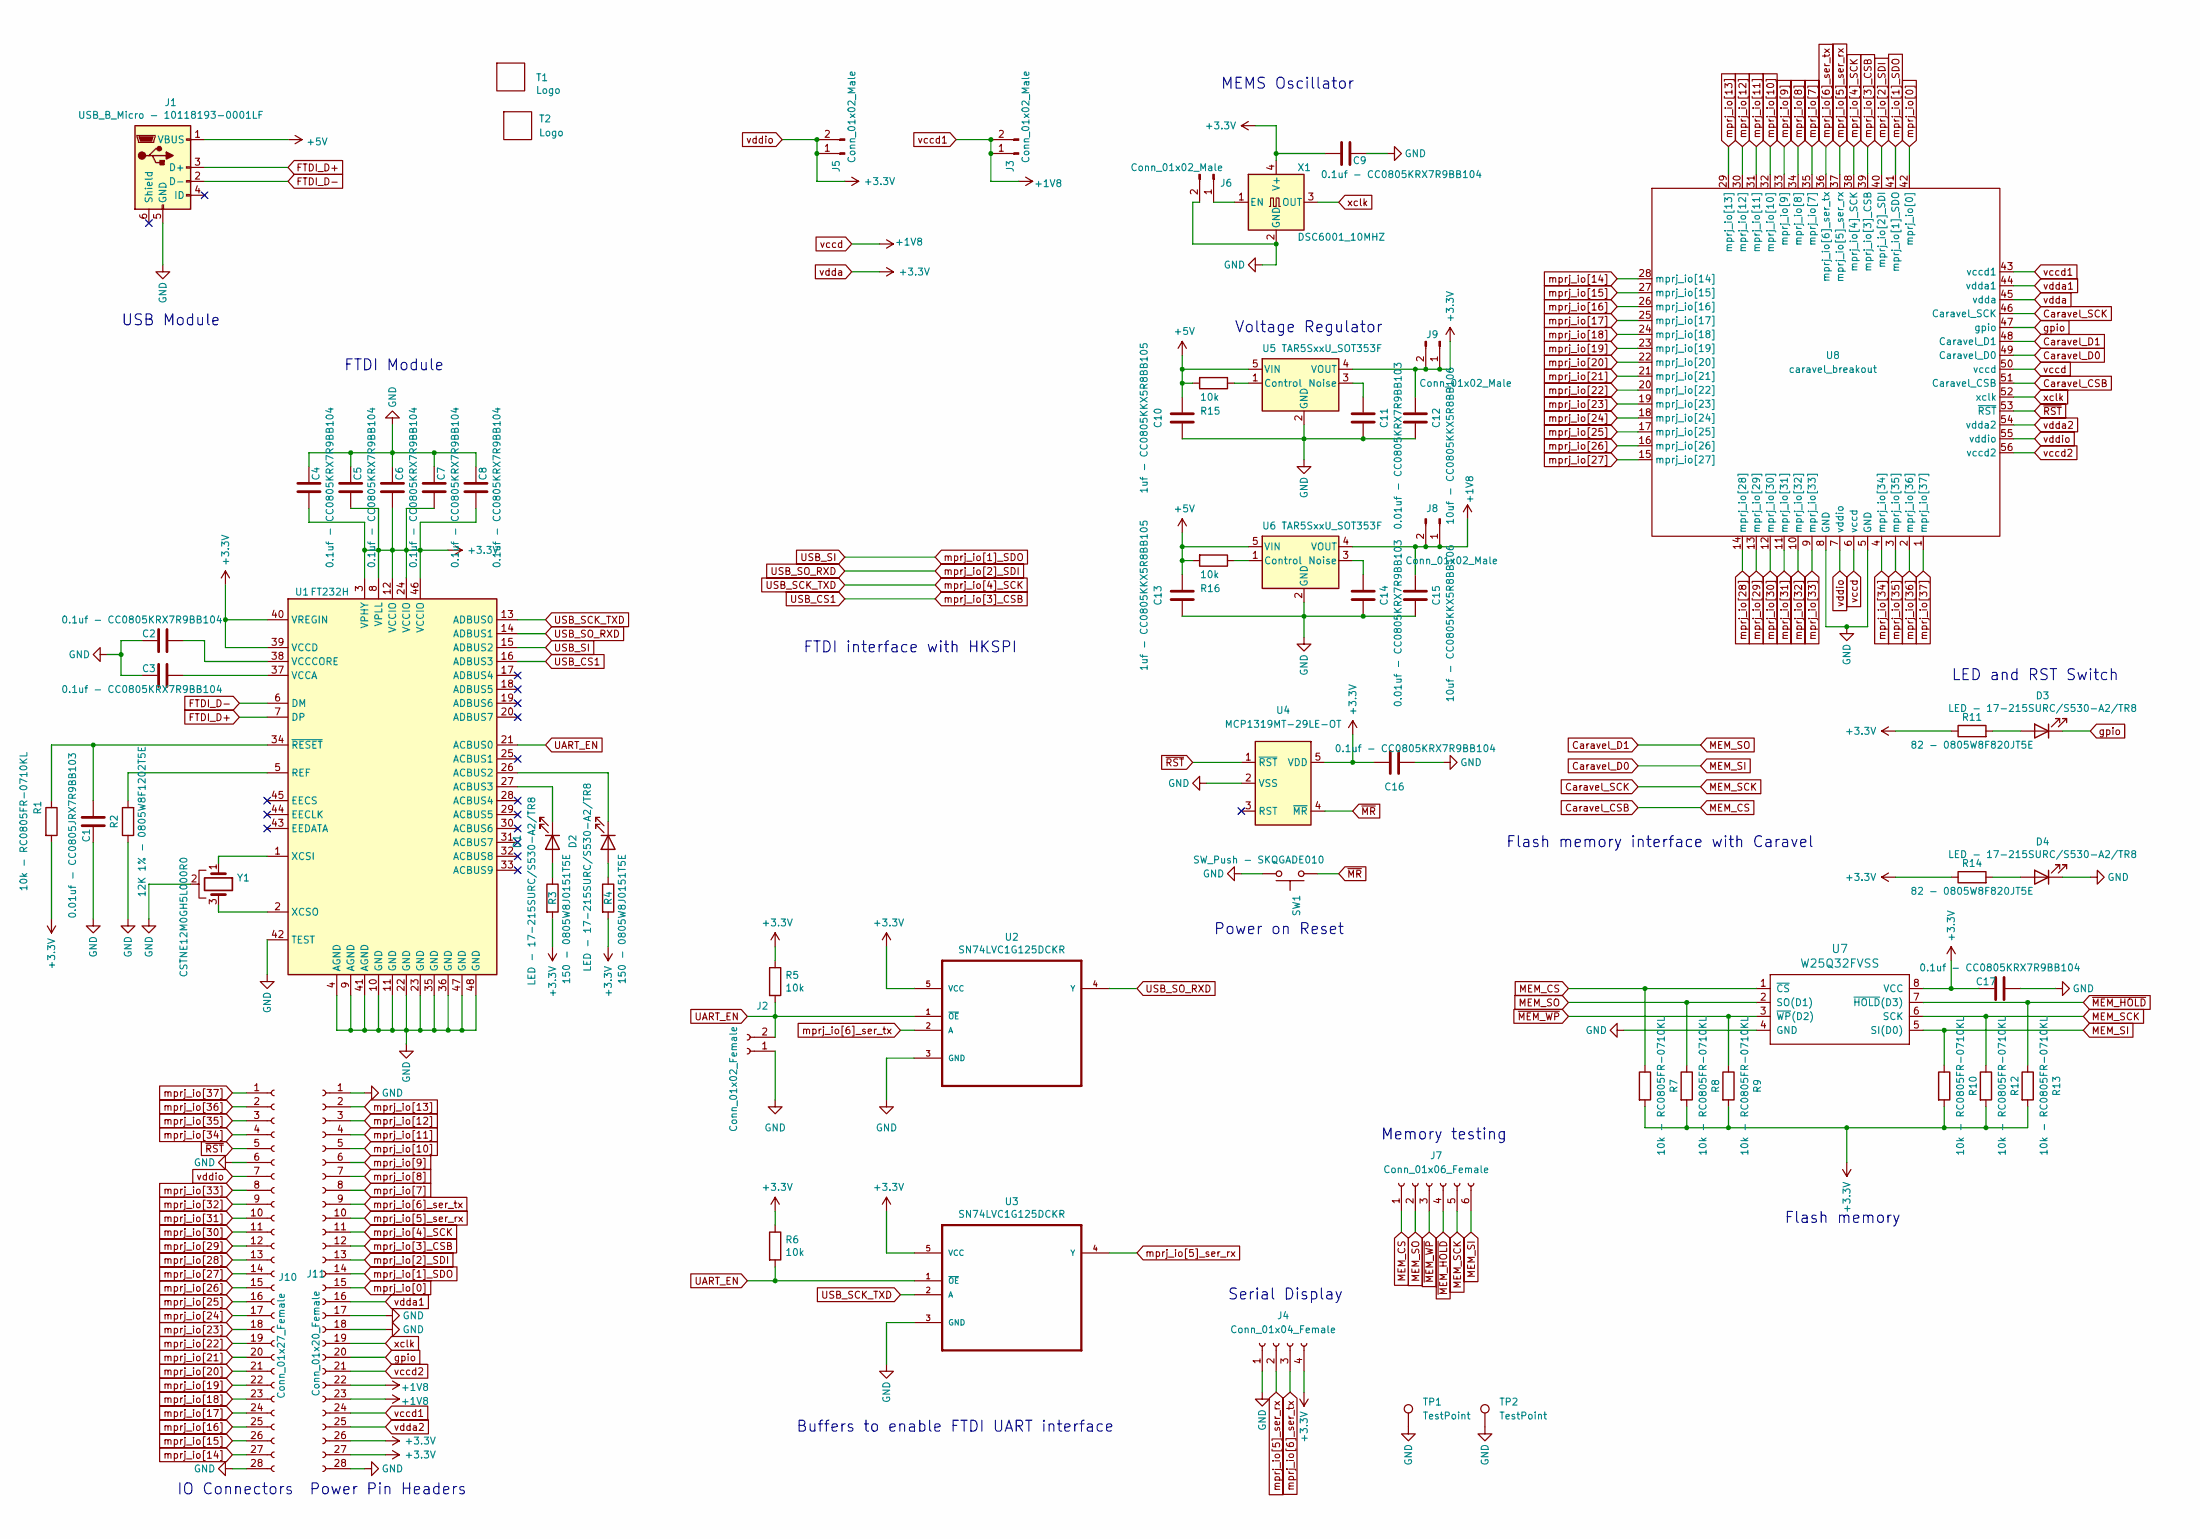
[picture p15: schematic caravel_pcb_v4_FTDI_flexy.kicad_sch]

Parts:
C1: 0.01uf - CC0805JRX7R9BB103; C_0805_2012Metric
C2, C3, C4, C5, C6, C7, C8, C9, C16, C17: 0.1uf - CC0805KRX7R9BB104; C_0805_2012Metric
C10, C13: 1uf - CC0805KKX5R8BB105; C_0805_2012Metric
C11, C14: 0.01uf - CC0805KRX7R9BB103; C_0805_2012Metric
C12, C15: 10uf - CC0805KKX5R8BB106; C_0805_2012Metric
D1, D2, D3, D4: LED - 17-215SURC/S530-A2/TR8; LED_1206_3216Metric
J1: USB_B_Micro - 10118193-0001LF; FCI_10118193-0001LF
J2: Conn_01x02_Female; PinHeader_1x02_P2.54mm_Vertical
J3, J5, J6, J8, J9: Conn_01x02_Male; PinHeader_1x02_P2.54mm_Vertical
J4: Conn_01x04_Female; PinHeader_1x04_P2.54mm_Vertical
J7: Conn_01x06_Female; PinHeader_1x06_P2.54mm_Vertical
J10: Conn_01x27_Female; PinHeader_1x27_P2.54mm_Vertical
J11: Conn_01x20_Female; PinHeader_1x20_P2.54mm_Vertical
R1, R7, R8, R9, R10, R12, R13: 10k - RC0805FR-0710KL; R_0805_2012Metric
R2: 12K 1% - 0805W8F1202T5E; R_0805_2012Metric
R3, R4: 150 - 0805W8J0151T5E; R_0805_2012Metric
R5, R6, R15, R16: 10k; R_0805_2012Metric
R11, R14: 82 - 0805W8F820JT5E; R_0805_2012Metric
SW1: SW_Push - SKQGADE010; SW4-SMD-5.2X5.2X1.5MM
T1: Logo; logo
T2: Logo; ef_logo
TP1, TP2: TestPoint; TestPoint_Bridge_Pitch2.54mm_Drill1.0mm
U1: FT232H; QFN-48-1EP_8x8mm_P0.5mm_EP6.2x6.2mm
U2, U3: SN74LVC1G125DCKR; SOT65P210X110-5N
U4: MCP1319MT-29LE-OT; PoR_5_SOT23
U5, U6: TAR5SxxU_SOT353F; SOT-353F
U7: W25Q32FVSS; SOIC127P790X216-8N
U8: caravel_breakout; caravel_breakout_flexy
X1: DSC6001_10MHZ; DSC6001JE1A-010.0000
Y1: CSTNE12M0GH5L000R0

Connections:
+5V: C10.2, C13.2, J1.1 (VBUS), R15.2, R16.2, U5.5 (VIN), U6.5 (VIN)
Caravel_CSB: J7.1, R7.1, U7.1 (~CS), U8.51 (Caravel_CSB)
Caravel_D0: J7.6, R10.1, U7.5 (SI(D0)), U8.49 (Caravel_D0)
Caravel_D1: J7.2, R8.1, U7.2 (SO(D1)), U8.48 (Caravel_D1)
Caravel_SCK: J7.5, R12.1, U7.6 (SCK), U8.46 (Caravel_SCK)
FTDI_D+: J1.3 (D+), U1.7 (DP)
FTDI_D-: J1.2 (D-), U1.6 (DM)
GND: C1.1, C2.1, C3.1, C4.1, C5.1, C6.1, C7.1, C8.1, C9.1, C10.1, C11.2, C12.1, C13.1, C14.2, C15.1, C16.1, C17.2, D4.1 (K), J1.5 (GND), J2.1, J4.1, J6.2, J10.6, J10.28, J11.1, J11.17, J11.18, J11.28, R2.1, SW1.2, TP1.1, TP2.1, U1.4 (AGND), U1.9 (AGND), U1.10 (GND), U1.11 (GND), U1.22 (GND), U1.23 (GND), U1.35 (GND), U1.36 (GND), U1.41 (AGND), U1.42 (TEST), U1.47 (GND), U1.48 (GND), U2.3 (GND), U3.3 (GND), U4.2 (VSS), U5.2 (GND), U6.2 (GND), U7.4 (GND), U8.5 (GND), U8.8 (GND), X1.2 (GND), Y1.2
unnamed: C1.2, R1.1, U1.34 (~RESET)
unnamed: C2.2, U1.38 (VCCCORE)
unnamed: C3.2, U1.37 (VCCA)
unnamed: C11.1, U5.3 (Noise)
unnamed: C14.1, U6.3 (Noise)
unnamed: D1.1 (K), U1.27 (ACBUS3)
unnamed: D1.2 (A), R3.1
unnamed: D2.1 (K), U1.26 (ACBUS2)
unnamed: D2.2 (A), R4.1
unnamed: D3.2 (A), R11.2
unnamed: D4.2 (A), R14.2
unnamed: J6.1, X1.1 (EN)
unnamed: R2.2, U1.5 (REF)
unnamed: R15.1, U5.1 (Control)
unnamed: R16.1, U6.1 (Control)
unnamed: U1.1 (XCSI), Y1.1
unnamed: U1.2 (XCSO), Y1.3
UART_EN: J2.2, R5.2, R6.2, U1.21 (ACBUS0), U2.1 (~OE), U3.1 (~OE)
USB_CS1: J11.12, U1.16 (ADBUS3), U8.39 (mprj_io[3]_CSB)
USB_SCK_TXD: J11.11, U1.13 (ADBUS0), U3.2 (A), U8.38 (mprj_io[4]_SCK)
USB_SI: J11.14, U1.15 (ADBUS2), U8.41 (mprj_io[1]_SDO)
USB_SO_RXD: J11.13, U1.14 (ADBUS1), U2.4 (Y), U8.40 (mprj_io[2]_SDI)
gpio: D3.1 (K), J11.20, U8.47 (gpio)
mprj_io[0]: J11.15, U8.42 (mprj_io[0])
mprj_io[5]_ser_rx: J4.2, J11.10, U3.4 (Y), U8.37 (mprj_io[5]_ser_rx)
mprj_io[6]_ser_tx: J4.3, J11.9, U2.2 (A), U8.36 (mprj_io[6]_ser_tx)
mprj_io[7]: J11.8, U8.35 (mprj_io[7])
mprj_io[8]: J11.7, U8.34 (mprj_io[8])
mprj_io[9]: J11.6, U8.33 (mprj_io[9])
mprj_io[10]: J11.5, U8.32 (mprj_io[10])
mprj_io[11]: J11.4, U8.31 (mprj_io[11])
mprj_io[12]: J11.3, U8.30 (mprj_io[12])
mprj_io[13]: J11.2, U8.29 (mprj_io[13])
mprj_io[14]: J10.27, U8.28 (mprj_io[14])
mprj_io[15]: J10.26, U8.27 (mprj_io[15])
mprj_io[16]: J10.25, U8.26 (mprj_io[16])
mprj_io[17]: J10.24, U8.25 (mprj_io[17])
mprj_io[18]: J10.23, U8.24 (mprj_io[18])
mprj_io[19]: J10.22, U8.23 (mprj_io[19])
mprj_io[20]: J10.21, U8.22 (mprj_io[20])
mprj_io[21]: J10.20, U8.21 (mprj_io[21])
mprj_io[22]: J10.19, U8.20 (mprj_io[22])
mprj_io[23]: J10.18, U8.19 (mprj_io[23])
mprj_io[24]: J10.17, U8.18 (mprj_io[24])
mprj_io[25]: J10.16, U8.17 (mprj_io[25])
mprj_io[26]: J10.15, U8.16 (mprj_io[26])
mprj_io[27]: J10.14, U8.15 (mprj_io[27])
mprj_io[28]: J10.13, U8.14 (mprj_io[28])
mprj_io[29]: J10.12, U8.13 (mprj_io[29])
mprj_io[30]: J10.11, U8.12 (mprj_io[30])
mprj_io[31]: J10.10, U8.11 (mprj_io[31])
mprj_io[32]: J10.9, U8.10 (mprj_io[32])
mprj_io[33]: J10.8, U8.9 (mprj_io[33])
mprj_io[34]: J10.4, U8.4 (mprj_io[34])
mprj_io[35]: J10.3, U8.3 (mprj_io[35])
mprj_io[36]: J10.2, U8.2 (mprj_io[36])
mprj_io[37]: J10.1, U8.1 (mprj_io[37])
vccd: C15.2, J3.1, J3.2, J8.1, J8.2, J11.22, J11.23, J11.24, U6.4 (VOUT), U8.6 (vccd), U8.43 (vccd1), U8.50 (vccd)
vccd2: J11.21, U8.56 (vccd2)
vdda: C4.2, C5.2, C6.2, C7.2, C8.2, C9.2, C12.2, C16.2, C17.1, J4.4, J5.1, J5.2, J9.1, J9.2, J10.7, J11.26, J11.27, R1.2, R3.2, R4.2, R5.1, R6.1, R7.2, R8.2, R9.2, R10.2, R11.1, R12.2, R13.2, R14.1, U1.3 (VPHY), U1.8 (VPLL), U1.12 (VCCIO), U1.24 (VCCIO), U1.39 (VCCD), U1.40 (VREGIN), U1.46 (VCCIO), U2.5 (VCC), U3.5 (VCC), U4.5 (VDD), U5.4 (VOUT), U7.8 (VCC), U8.7 (vddio), U8.45 (vdda), U8.55 (vddio), X1.4 (V+)
vdda1: J11.16, U8.44 (vdda1)
vdda2: J11.25, U8.54 (vdda2)
xclk: J11.19, U8.52 (xclk), X1.3 (OUT)
~MEM_HOLD: J7.4, R13.1, U7.7 (~HOLD(D3))
~MEM_WP: J7.3, R9.1, U7.3 (~WP(D2))
~MR: SW1.1, U4.4 (~MR)
~RST: J10.5, U4.1 (~RST), U8.53 (~RST)

Notes on the sheet:
Serial Display
LED and RST Switch
Flash memory interface with Caravel
Power on Reset
Flash memory
Memory testing
FTDI interface with HKSPI
Power Pin Headers
Voltage Regulator
IO Connectors
FTDI Module
USB Module
MEMS Oscillator
Buffers to enable FTDI UART interface

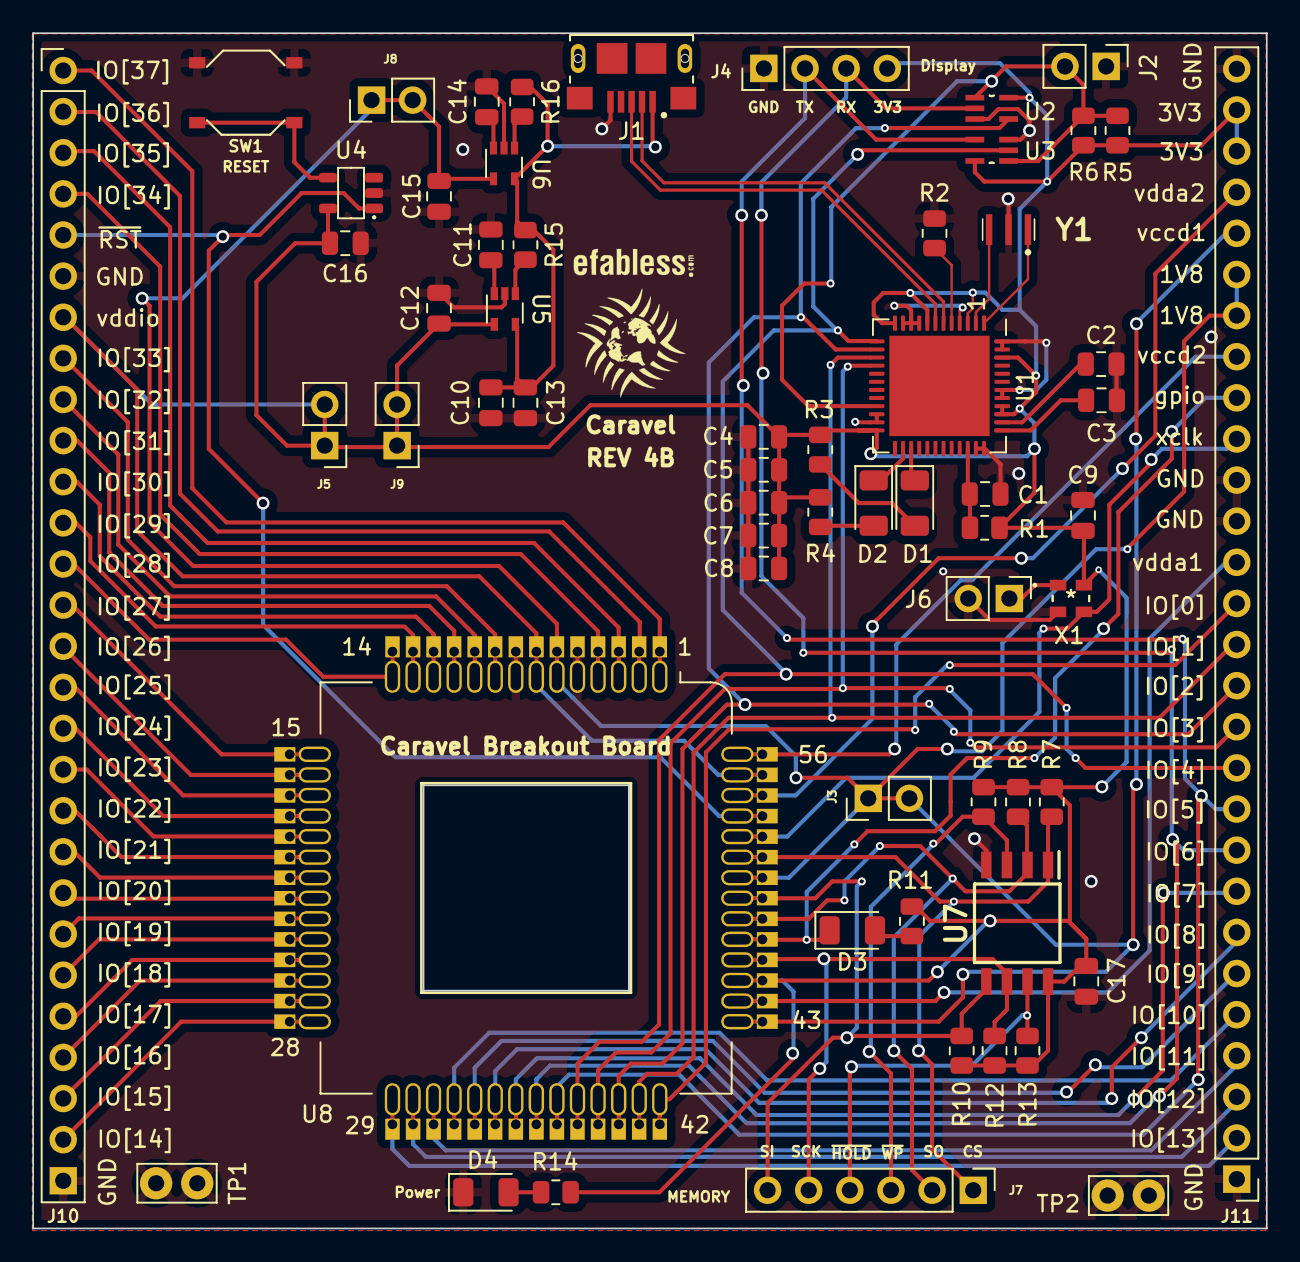
[picture p16: board caravel_pcb_v4_FTDI_flexy.kicad_pcb from above]

Board: 2 copper layers, 76.2 x 73.8 mm, 63 parts (0 on the bottom side), 75 nets.
