dsatizabal/cpuy/caravel_board/hardware/breakout/_archive/caravel_breakout_QFN/caravel_breakout_QFN.kicad_pcb

## KiCad design caravel_board/hardware/breakout/_archive/caravel_breakout_QFN/caravel_breakout_QFN.kicad_pcb (2025-09-26, an earlier design)

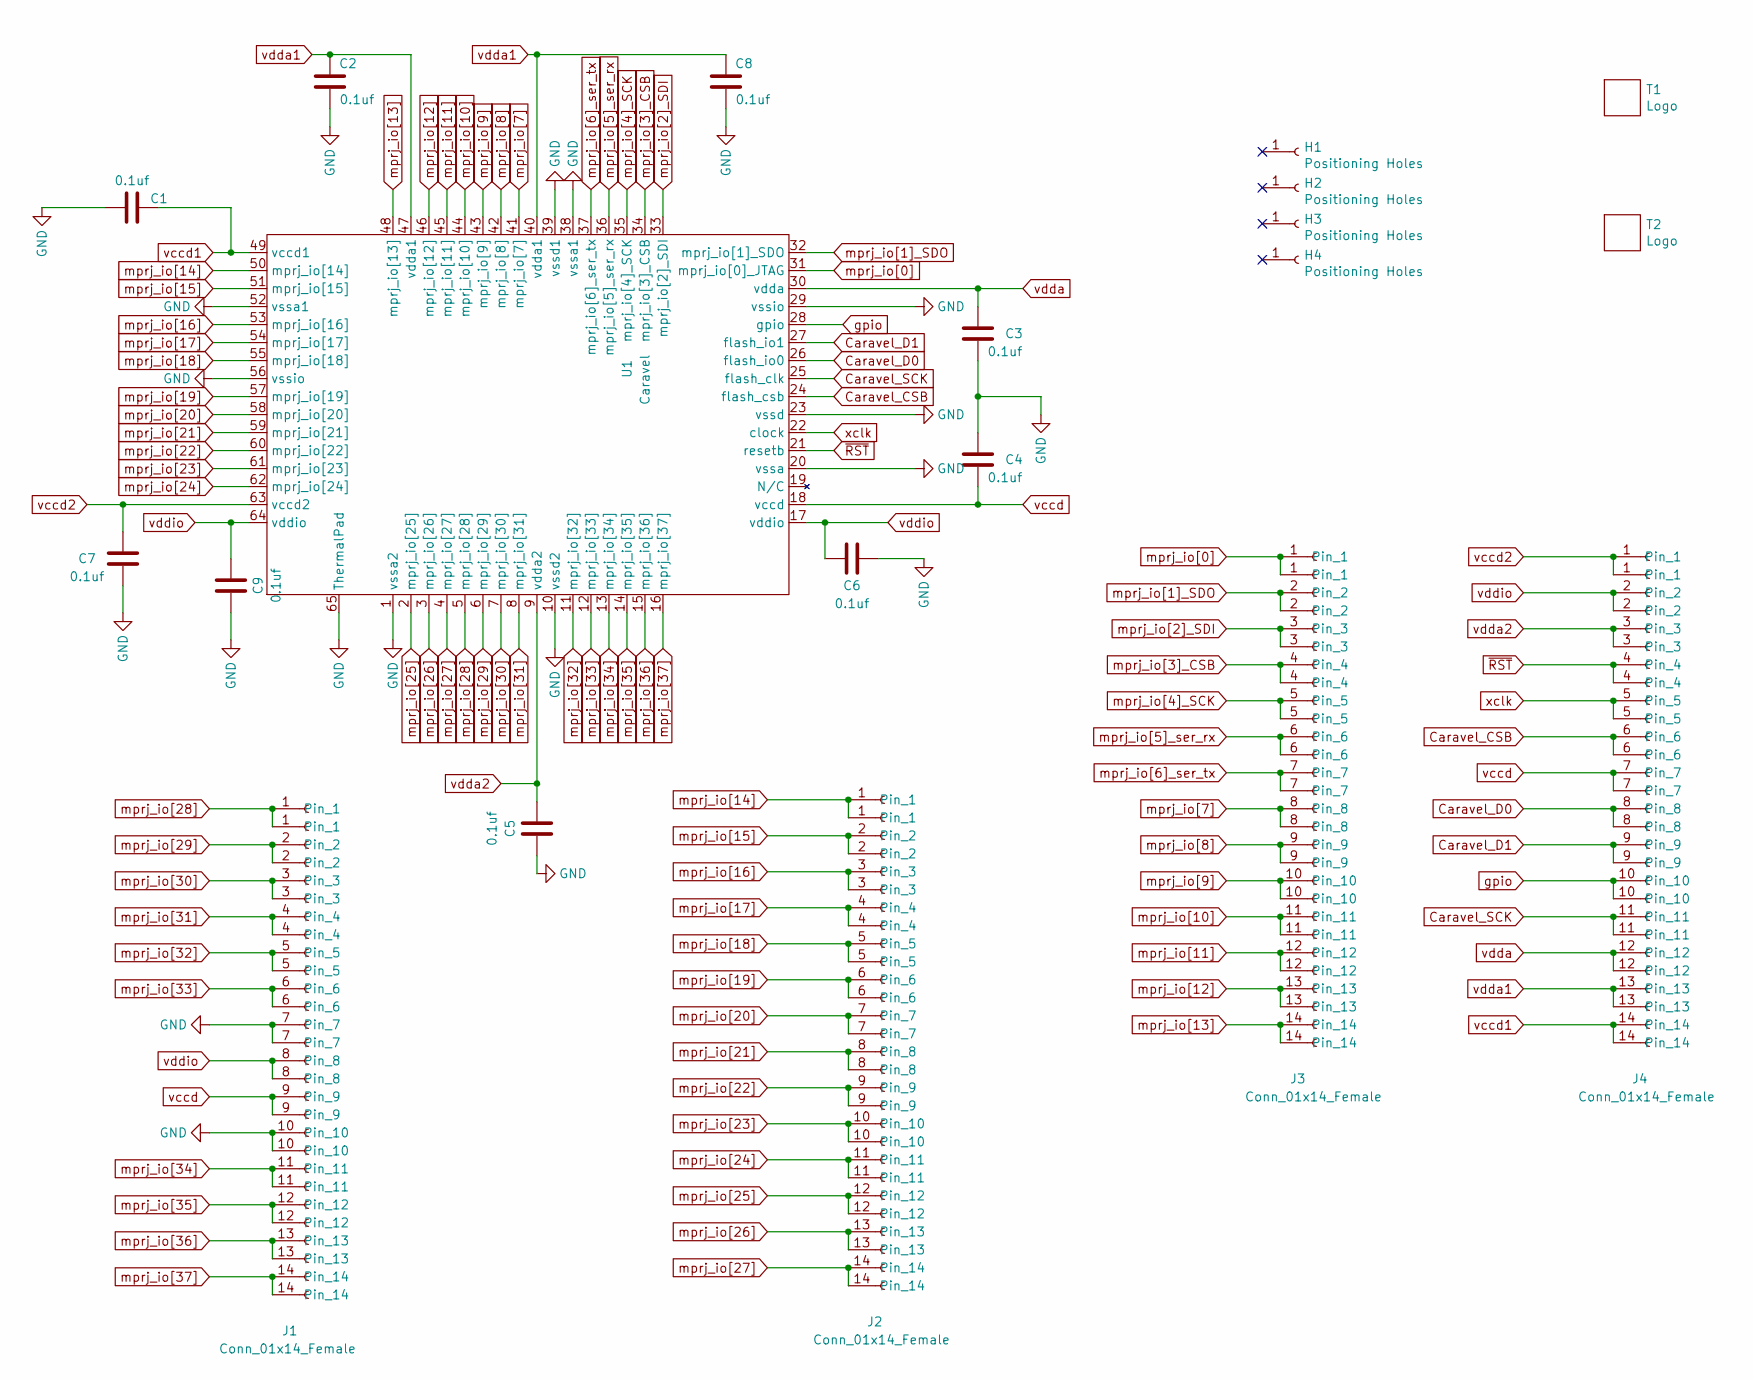
[picture p17: schematic caravel_breakout_QFN.kicad_sch]

Parts:
C1, C2, C3, C4, C5, C6, C7, C8, C9: 0.1uf; C_0402_1005Metric
H1, H2, H3, H4: Positioning Holes; MountingHole_2.2mm_M2_ISO7380_Pad
J1, J2, J3, J4: Conn_01x14_Female; Caravel_Breakout_Connectors_2x14
T1: Logo; logo_small
T2: Logo; ef_logo
U1: Caravel; QFN-64-1EP_9x9mm_P0.5mm_EP7.65x7.65mm

Connections:
Caravel_CSB: J4.6, U1.24 (flash_csb)
Caravel_D0: J4.8, U1.26 (flash_io0)
Caravel_D1: J4.9, U1.27 (flash_io1)
Caravel_SCK: J4.11, U1.25 (flash_clk)
GND: C1.1, C2.2, C3.2, C4.1, C5.1, C6.1, C7.1, C8.2, C9.1, J1.7, J1.10, U1.1 (vssa2), U1.10 (vssd2), U1.20 (vssa), U1.23 (vssd), U1.29 (vssio), U1.38 (vssa1), U1.39 (vssd1), U1.52 (vssa1), U1.56 (vssio), U1.65 (ThermalPad)
gpio: J4.10, U1.28 (gpio)
mprj_io[0]: J3.1, U1.31 (mprj_io[0]_JTAG)
mprj_io[1]_SDO: J3.2, U1.32 (mprj_io[1]_SDO)
mprj_io[2]_SDI: J3.3, U1.33 (mprj_io[2]_SDI)
mprj_io[3]_CSB: J3.4, U1.34 (mprj_io[3]_CSB)
mprj_io[4]_SCK: J3.5, U1.35 (mprj_io[4]_SCK)
mprj_io[5]_ser_rx: J3.6, U1.36 (mprj_io[5]_ser_rx)
mprj_io[6]_ser_tx: J3.7, U1.37 (mprj_io[6]_ser_tx)
mprj_io[7]: J3.8, U1.41 (mprj_io[7])
mprj_io[8]: J3.9, U1.42 (mprj_io[8])
mprj_io[9]: J3.10, U1.43 (mprj_io[9])
mprj_io[10]: J3.11, U1.44 (mprj_io[10])
mprj_io[11]: J3.12, U1.45 (mprj_io[11])
mprj_io[12]: J3.13, U1.46 (mprj_io[12])
mprj_io[13]: J3.14, U1.48 (mprj_io[13])
mprj_io[14]: J2.1, U1.50 (mprj_io[14])
mprj_io[15]: J2.2, U1.51 (mprj_io[15])
mprj_io[16]: J2.3, U1.53 (mprj_io[16])
mprj_io[17]: J2.4, U1.54 (mprj_io[17])
mprj_io[18]: J2.5, U1.55 (mprj_io[18])
mprj_io[19]: J2.6, U1.57 (mprj_io[19])
mprj_io[20]: J2.7, U1.58 (mprj_io[20])
mprj_io[21]: J2.8, U1.59 (mprj_io[21])
mprj_io[22]: J2.9, U1.60 (mprj_io[22])
mprj_io[23]: J2.10, U1.61 (mprj_io[23])
mprj_io[24]: J2.11, U1.62 (mprj_io[24])
mprj_io[25]: J2.12, U1.2 (mprj_io[25])
mprj_io[26]: J2.13, U1.3 (mprj_io[26])
mprj_io[27]: J2.14, U1.4 (mprj_io[27])
mprj_io[28]: J1.1, U1.5 (mprj_io[28])
mprj_io[29]: J1.2, U1.6 (mprj_io[29])
mprj_io[30]: J1.3, U1.7 (mprj_io[30])
mprj_io[31]: J1.4, U1.8 (mprj_io[31])
mprj_io[32]: J1.5, U1.11 (mprj_io[32])
mprj_io[33]: J1.6, U1.12 (mprj_io[33])
mprj_io[34]: J1.11, U1.13 (mprj_io[34])
mprj_io[35]: J1.12, U1.14 (mprj_io[35])
mprj_io[36]: J1.13, U1.15 (mprj_io[36])
mprj_io[37]: J1.14, U1.16 (mprj_io[37])
vccd: C4.2, J1.9, J4.7, U1.18 (vccd)
vccd1: C1.2, J4.14, U1.49 (vccd1)
vccd2: C7.2, J4.1, U1.63 (vccd2)
vdda: C3.1, J4.12, U1.30 (vdda)
vdda1: C2.1, C8.1, J4.13, U1.40 (vdda1), U1.47 (vdda1)
vdda2: C5.2, J4.3, U1.9 (vdda2)
vddio: C6.2, C9.2, J1.8, J4.2, U1.17 (vddio), U1.64 (vddio)
xclk: J4.5, U1.22 (clock)
~RST: J4.4, U1.21 (resetb)

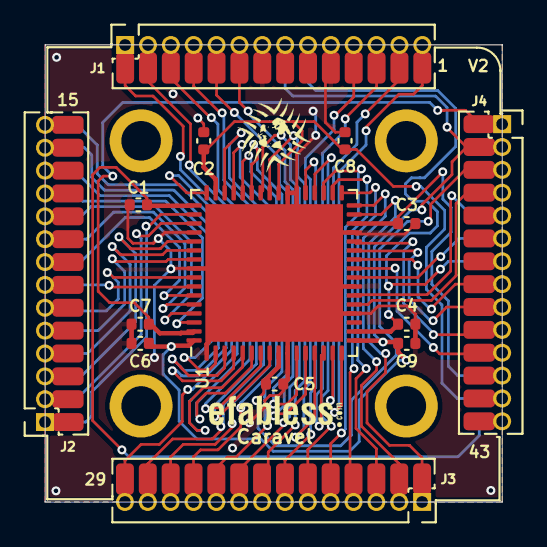
[picture p18: board caravel_breakout_QFN.kicad_pcb from above]

Board: 2 copper layers, 25.4 x 25.4 mm, 20 parts (0 on the bottom side), 53 nets.
