dsatizabal/cpuy/caravel_board/hardware/development/_archive/caravel_pcb_v3_MCP/caravel_pcb_v3_MCP.kicad_pcb

## KiCad design caravel_board/hardware/development/_archive/caravel_pcb_v3_MCP/caravel_pcb_v3_MCP.kicad_pcb (2025-09-26, an earlier design)

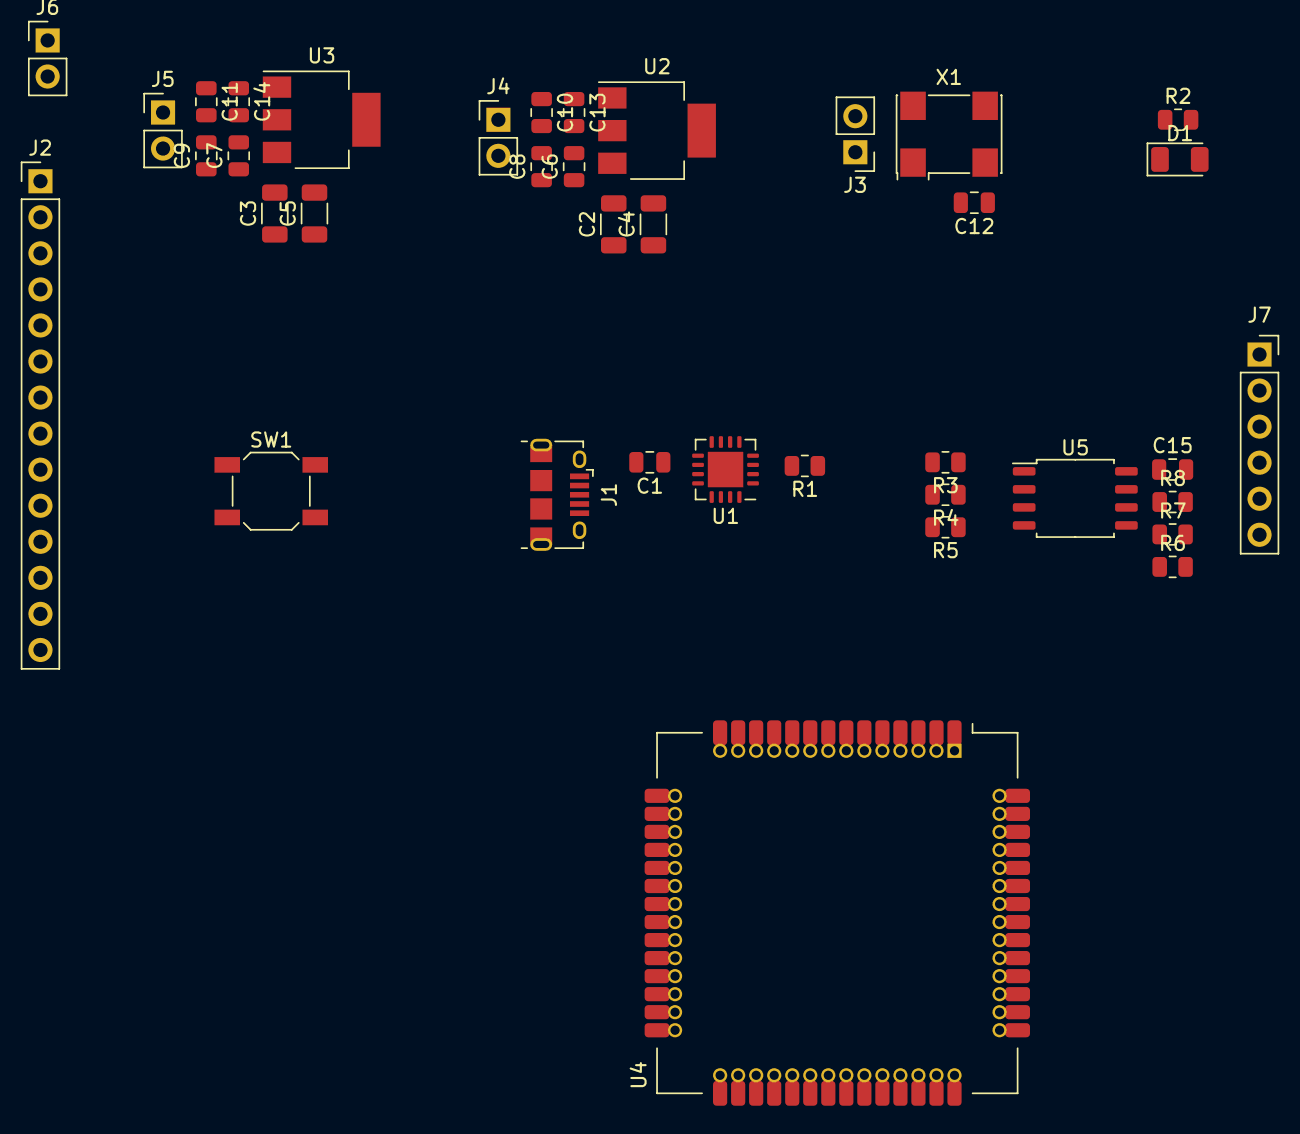
[picture p28: board caravel_pcb_v3_MCP.kicad_pcb from above]

Board: 2 copper layers, 38 parts (0 on the bottom side), 29 nets, no tracks yet.

Parts:
C1: 0.47uf; C_0805_2012Metric
C2, C3, C4, C5: 100uf - GRM31CR60J107ME39L; C_1206_3216Metric
C6, C7, C10, C11: 10uf - CC0805KKX5R8BB106; C_0805_2012Metric
C8, C9: 22uf - CC0805MKX5R5BB226; C_0805_2012Metric
C12, C15: 0.1uf - CC0805KRX7R9BB104; C_0805_2012Metric
C13, C14: 1uf; C_0805_2012Metric
D1: LED - 17-215SURC/S530-A2/TR8; LED_1206_3216Metric
J1: USB_B_Micro - 10118194-0001LF; USB_Micro-B_Amphenol_10118194_Horizontal
J2: Conn_01x14_Female; PinHeader_1x14_P2.54mm_Vertical
J3, J4, J5, J6: Conn_01x02_Male; PinHeader_1x02_P2.54mm_Vertical
J7: Conn_01x06_Female; PinSocket_1x06_P2.54mm_Vertical
R1, R3, R4, R5, R6, R7, R8: 10k - RC0805FR-0710KL; R_0805_2012Metric
R2: 82 - 0805W8F820JT5E; R_0805_2012Metric
SW1: SW_Push - SKQGADE010; SW_SPST_SKQG_WithStem
U1: MCP2221AxML; QFN-16-1EP_4x4mm_P0.65mm_EP2.5x2.5mm
U2: AZ1117CH-1.8TRG1; SOT-223-3_TabPin2
U3: AZ1117-3.3; SOT-223-3_TabPin2
U4: caravel_breakout; caravel_breakout_v1
U5: W25Q32FVSS; SOIC-8_5.23x5.23mm_P1.27mm
X1: ASV-10.000MHZ-EJ-T; Oscillator_SMD_Abracon_ASV-4Pin_7.0x5.1mm

Connections:
+5V: C2.2, C3.2, C4.2, C5.2, C6.2, C7.2, J1.1 (VBUS), U1.16 (VDD), U2.3 (VI), U3.3 (VI)
Caravel_CSB: J7.1, R3.1, U4.6 (Caravel_CSB), U5.1 (~CS)
Caravel_D0: J7.5, R6.1, U4.8 (Caravel_D0), U5.5 (SI(D0))
Caravel_D1: J7.2, R4.1, U4.9 (Caravel_D1), U5.2 (SO(D1))
Caravel_SCK: J7.6, R7.1, U4.11 (Caravel_SCK), U5.6 (SCK)
GND: C1.2, C2.1, C3.1, C4.1, C5.1, C6.1, C7.1, C8.1, C9.1, C10.1, C11.1, C12.1, C13.1, C14.1, C15.2, J1.5 (GND), J2.2, J2.3, J3.2, R1.1, SW1.2, U1.13 (VSS), U2.1 (GND), U3.1 (GND), U4.49 (GND), U4.52 (GND), U5.4 (GND), X1.2 (GND)
MCP_D+: J1.3 (D+), U1.12 (D+)
MCP_D-: J1.2 (D-), U1.11 (D-)
unnamed: C1.1, U1.10 (VUSB)
unnamed: D1.2 (A), R2.2
unnamed: J3.1, X1.1 (EN)
unnamed: R1.2, U1.3 (~RST)
USB_CS: U1.1 (GP0), U4.18 (mprj_io[3]_CSB)
USB_MISO: U1.6 (GP2), U4.16 (mprj_io[1]_SDO)
USB_MOSI: U1.7 (GP3), U4.17 (mprj_io[2]_SDI)
USB_SCK: U1.2 (GP1), U4.19 (mprj_io[4]_SCK)
gpio: D1.1 (K), J2.5, U4.10 (gpio)
mprj_io[5]_ser_rx: U1.5 (UTx), U4.20 (mprj_io[5]_ser_rx)
mprj_io[6]_ser_tx: U1.4 (URx), U4.21 (mprj_io[6]_ser_tx)
vccd: C8.2, C10.2, C13.2, J2.1, J2.7, J2.8, J4.1, J4.2, U2.2 (VO), U4.7 (vccd), U4.51 (vccd)
vccd1: J2.9, U4.14 (vccd1)
vccd2: J2.6, U4.1 (vccd2)
vdda: C9.2, C11.2, C12.2, C14.2, C15.1, J2.11, J2.12, J2.14, J5.1, J5.2, J6.1, J6.2, R2.1, R3.2, R4.2, R5.2, R6.2, R7.2, R8.2, U3.2 (VO), U4.2 (vddio), U4.12 (vdda), U4.50 (vddio), U5.8 (VCC), X1.4 (V+)
vdda1: J2.13, U4.13 (vdda1)
vdda2: J2.10, U4.3 (vdda2)
xclk: J2.4, U4.5 (xclk), X1.3 (OUT)
~MEM_HOLD: J7.4, R8.1, U5.7 (~HOLD(D3))
~MEM_WP: J7.3, R5.1, U5.3 (~WP(D2))
~RST: SW1.1, U4.4 (~RST)
