dsatizabal/cpuy/caravel_board/hardware/breakout/_archive/caravel_daughter/Caravel_daughter.kicad_pcb

## KiCad design caravel_board/hardware/breakout/_archive/caravel_daughter/Caravel_daughter.kicad_pcb (2025-09-26, an earlier design)

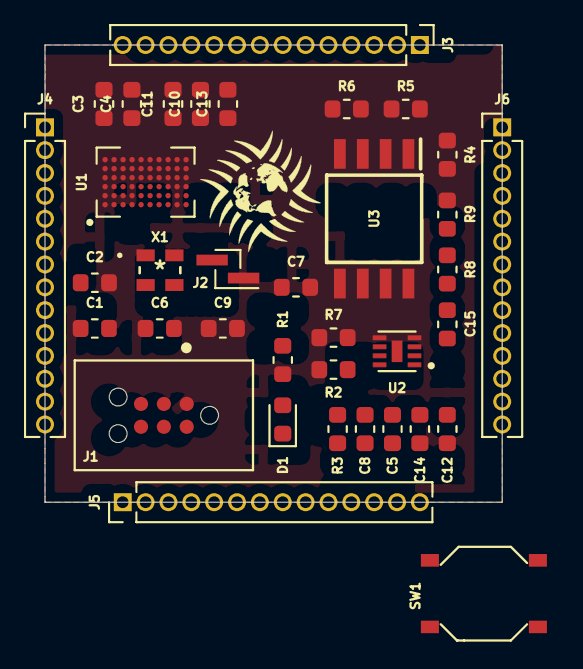
[picture p29: board Caravel_daughter.kicad_pcb from above]

Board: 2 copper layers, 25.4 x 25.4 mm, 37 parts (0 on the bottom side), 57 nets, no tracks yet.

Parts:
C1, C2, C3, C4, C6, C7, C8, C9, C10, C11, C13, C15: 0.1uf; C_0603_1608Metric
C5: 10uf; C_0603_1608Metric
C12, C14: 2.2uf; C_0603_1608Metric
D1: LED - 17-215SURC/S530-A2/TR8; LED_0603_1608Metric
J1: TC2030-IDC-NL; TAG_TC2030-IDC-NL
J2: Conn_01x02_Male; PinHeader_1x02_P1.00mm_Vertical_SMD_Pin1Left
J3, J4, J5, J6: Conn_01x14_Female; PinHeader_1x14_P1.27mm_Vertical
R1: 82 - 0805W8F820JT5E; R_0603_1608Metric
R2, R3: 100; R_0603_1608Metric
R4, R5, R6, R7, R8, R9: 10k; R_0603_1608Metric
SW1: SW_Push - SKQGADE010; SW4-SMD-5.2X5.2X1.5MM
T1: Logo; logo
U1: Caravel; Caravel_WCSP
U2: MIC5350-SGYMT-TR; SON50P200X200X60-9N
U3: W25Q32FVSS; SOIC127P790X216-8N
X1: DSC6001_10MHZ; DSC6001JE1A-010.0000

Connections:
+1V8: C11.2, C14.2, J6.2, J6.3, U1.A10, U2.7
+3V3: C12.2, C13.1, J6.6, J6.7, R1.1, U1.F10, U2.8
+5V: C5.2, J1.6, J6.14, R2.2, R3.2, U2.1
Caravel_CSB: R4.1, U1.C10, U3.1
Caravel_D0: R7.1, U1.D10, U3.5
Caravel_D1: R5.1, U1.D9, U3.2
Caravel_SCK: R8.1, U1.D8, U3.6
GND: C1.1, C2.1, C3.2, C4.1, C5.1, C6.1, C7.2, C8.1, C9.1, C10.1, C11.1, C12.1, C13.2, C14.1, C15.2, J1.1, J2.2, SW1.2, U1.B3, U1.B7, U1.C5, U1.C6, U1.D5, U1.D6, U1.E6, U1.F6, U2.2, U2.9, U3.4, X1.2
unnamed: C8.2, U2.3
unnamed: D1.2, R1.2
unnamed: J2.1, X1.1
unnamed: R2.1, U2.4
unnamed: R3.1, U2.5
unnamed: R6.1, U3.3
unnamed: R9.1, U3.7
gpio: D1.1, U1.E10
mprj_io[0]: J3.1, U1.D7
mprj_io[1]_SDO: J3.2, U1.E9
mprj_io[2]_SDI: J3.3, U1.F9
mprj_io[3]_CSB: J3.4, U1.E8
mprj_io[4]_SCK: J3.5, U1.F8
mprj_io[5]_ser_rx: J1.2, J3.6, U1.E7
mprj_io[6]_ser_tx: J1.3, J3.7, U1.F7
mprj_io[7]: J3.8, U1.E5
mprj_io[8]: J3.9, U1.F5
mprj_io[9]: J3.10, U1.E4
mprj_io[10]: J3.11, U1.F4
mprj_io[11]: J3.12, U1.E3
mprj_io[12]: J3.13, U1.F3
mprj_io[13]: J3.14, U1.D3
mprj_io[14]: J4.1, U1.E2
mprj_io[15]: J4.2, U1.F1
mprj_io[16]: J4.3, U1.E1
mprj_io[17]: J4.4, U1.D2
mprj_io[18]: J4.5, U1.D1
mprj_io[19]: J4.6, U1.C1
mprj_io[20]: J4.7, U1.C2
mprj_io[21]: J4.8, U1.B1
mprj_io[22]: J4.9, U1.B2
mprj_io[23]: J4.10, U1.A1
mprj_io[24]: J4.11, U1.C3
mprj_io[25]: J4.12, U1.A3
mprj_io[26]: J4.13, U1.B4
mprj_io[27]: J4.14, U1.A4
mprj_io[28]: J5.1, U1.B5
mprj_io[29]: J5.2, U1.A5
mprj_io[30]: J5.3, U1.B6
mprj_io[31]: J5.4, U1.A6
mprj_io[32]: J5.5, U1.A7
mprj_io[33]: J5.6, U1.C8
vccd1: C3.1, J6.4, U1.F2
vccd2: C1.2, J6.1, U1.A2
vdda1: C4.2, C7.1, J6.8, U1.D4
vdda2: C6.2, J6.5, U1.C7
vddio: C2.2, C9.2, C10.2, C15.1, R4.2, R5.2, R6.2, R7.2, R8.2, R9.2, U1.C4, U3.8, X1.4
xclk: U1.C9, X1.3
~RST: SW1.1, U1.B10
