dsatizabal/cpuy/firmware/custom_firmware/cpuy_bringup/cpuy_bringup.c

#include <defs.h>
#include <stub.h>

void configure_gpio()
{  
    // RESET
    reg_mprj_io_6 = GPIO_MODE_USER_STD_INPUT_PULLDOWN;
    
    // EXTERNAL INTERRUPT
    reg_mprj_io_7 = GPIO_MODE_USER_STD_INPUT_PULLDOWN;
    
    // DATA
    reg_mprj_io_8 = GPIO_MODE_USER_STD_INPUT_PULLDOWN;    
    reg_mprj_io_9 = GPIO_MODE_USER_STD_INPUT_PULLDOWN;
    reg_mprj_io_10 = GPIO_MODE_USER_STD_INPUT_PULLDOWN;
    reg_mprj_io_11 = GPIO_MODE_USER_STD_INPUT_PULLDOWN;
    reg_mprj_io_12 = GPIO_MODE_USER_STD_INPUT_PULLDOWN;
    reg_mprj_io_13 = GPIO_MODE_USER_STD_INPUT_PULLDOWN;
    reg_mprj_io_14 = GPIO_MODE_USER_STD_INPUT_PULLDOWN;
    reg_mprj_io_15 = GPIO_MODE_USER_STD_INPUT_PULLDOWN;

    // PORT 0
    reg_mprj_io_16 = GPIO_MODE_USER_STD_OUTPUT;
    reg_mprj_io_17 = GPIO_MODE_USER_STD_OUTPUT;
    reg_mprj_io_18 = GPIO_MODE_USER_STD_OUTPUT;
    reg_mprj_io_19 = GPIO_MODE_USER_STD_OUTPUT;
    reg_mprj_io_20 = GPIO_MODE_USER_STD_OUTPUT;
    reg_mprj_io_21 = GPIO_MODE_USER_STD_OUTPUT;
    reg_mprj_io_22 = GPIO_MODE_USER_STD_OUTPUT;
    reg_mprj_io_23 = GPIO_MODE_USER_STD_OUTPUT;

    // PORT 1
    reg_mprj_io_24 = GPIO_MODE_USER_STD_OUTPUT;
    reg_mprj_io_25 = GPIO_MODE_USER_STD_OUTPUT;
    reg_mprj_io_26 = GPIO_MODE_USER_STD_OUTPUT;
    reg_mprj_io_27 = GPIO_MODE_USER_STD_OUTPUT;
    
    // ADDRESS
    reg_mprj_io_28 = GPIO_MODE_USER_STD_OUTPUT;
    reg_mprj_io_29 = GPIO_MODE_USER_STD_OUTPUT;
    reg_mprj_io_30 = GPIO_MODE_USER_STD_OUTPUT;
    reg_mprj_io_31 = GPIO_MODE_USER_STD_OUTPUT;
    reg_mprj_io_32 = GPIO_MODE_USER_STD_OUTPUT;
    reg_mprj_io_33 = GPIO_MODE_USER_STD_OUTPUT;
    reg_mprj_io_34 = GPIO_MODE_USER_STD_OUTPUT;
    reg_mprj_io_35 = GPIO_MODE_USER_STD_OUTPUT;
    reg_mprj_io_36 = GPIO_MODE_USER_STD_OUTPUT;
    reg_mprj_io_37 = GPIO_MODE_USER_STD_OUTPUT;

    // Initiate the serial transfer to configure IO
    reg_mprj_xfer = 1;
    while (reg_mprj_xfer == 1);
}

void main()
{

    configure_gpio();

    // Prepare the values that WILL be written into the
    // mux registers after 2 mux_conf_clk rising edges:
    uint32_t la1;
    reg_la1_data = la1 =
     0b01111111101001110000000000000000;
    // 0-------------------------------     mux_conf_clk: Start with mux configuration clock low
    // -11111111-----------------------     i_design_reset[7:0]: All asserted
    // ---------0----------------------     i_mux_auto_reset_enb: 0=auto-reset non-selected designs
    // ----------1---------------------     i_mux_sys_reset_enb: 1=do not use wb_rst_i as a reset
    // -----------0011-----------------     i_mux_sel[3:0]=0011: We'll select design 3 (cpuy)
    // ---------------1----------------     i_mux_io5_reset_enb: 1=Do not use io[5] as a reset
    // ----------------XXXXXXXXXXXXXXXX     Unused.

    // Pulse mux_conf_clk once...
    reg_la1_data = (la1 |= 0x80000000);
    reg_la1_data = (la1 ^= 0x80000000);
    // ...and again:
    reg_la1_data = (la1 |= 0x80000000);
    reg_la1_data = (la1 ^= 0x80000000);

    // Design 3 should now be selected and free running!
}
