dsatizabal/cpuy/verilog/ucode.v

`default_nettype none

module ucode (
    input wire [7:0] opcode,
    input wire [7:0] w,
    input wire carry,
    input wire zero,
    input wire sign,
    output wire alu_operation,
    output wire alu_multibyte_result,
    output wire jump_operation,
    output wire jump_condition,
    output wire mov_operation,
    output wire destination_w,
    output wire destination_flags, // TODO: remove this unrequired signal
    output wire destination_memory,
    output wire destination_registers,
    output wire destination_ports,
    output wire [2:0] destination_index,
    output wire ram_operand,
    output wire duplicate_w,
    output wire source_ports,
    output wire source_registers,
    output wire stack_operation,
    output wire stack_direction, // 0 Pop, 1 Push
	output wire destination_cpu_config,
	output wire destination_timer_config,
	output wire destination_ports_config,
	output wire source_operands
);
	reg alu_op;
    reg alu_mb;
    reg jmp_op;
    reg jmp_condition;
    reg mov_op;
    reg dst_w;
    reg dst_f;
    reg dst_memory;
    reg dst_reg;
    reg dst_por;
    reg [2:0] dst_index;
    reg ram_op;
    reg dup_w;
    reg src_port;
    reg src_reg;
    reg stack_op;
    reg stack_dir;
	reg dst_cpu_cfg;
	reg dst_tmr_cfg;
	reg dst_ports_cfg;
	reg src_op;

    assign alu_operation = alu_op;
    assign alu_multibyte_result = alu_mb;
    assign jump_operation = jmp_op;
    assign jump_condition = jmp_condition;
    assign mov_operation = mov_op;
    assign destination_w = dst_w;
    assign destination_flags = dst_f;
    assign destination_memory = dst_memory;
    assign destination_registers = dst_reg;
    assign destination_ports = dst_por;
	assign destination_index = dst_index;
	assign ram_operand = ram_op;
	assign duplicate_w = dup_w;
    assign source_ports = src_port;
    assign source_registers = src_reg;
    assign stack_operation = stack_op;
    assign stack_direction = stack_dir;
	assign destination_cpu_config = dst_cpu_cfg;
	assign destination_timer_config = dst_tmr_cfg;
	assign destination_ports_config = dst_ports_cfg;
	assign source_operands = src_op;

	always @(*) begin
		alu_op = 0;
		alu_mb = 0;
		jmp_op = 0;
		jmp_condition = 0;
		mov_op = 0;
		dst_w = 0;
		dst_f = 0;
		dst_memory = 0;
		dst_reg = 0;
		dst_por = 0;
		dst_index = 0;
		ram_op = 0;
    	dup_w = 0;
    	src_port = 0;
    	src_reg = 0;
		stack_op = 0;
		stack_dir = 0;
		dst_cpu_cfg = 0;
		dst_tmr_cfg = 0;
		dst_ports_cfg = 0;
		src_op = 0;

		case (opcode)
			// Instructions without operands
			8'b0000_0000: begin // NOP does nothing
				alu_op = 0;
				alu_mb = 0;
				jmp_op = 0;
				jmp_condition = 0;
				mov_op = 0;
				dst_w = 0;
				dst_f = 0;
				dst_memory = 0;
				dst_reg = 0;
				dst_por = 0;
				dst_index = 0;
				ram_op = 0;
				dup_w = 0;
				src_port = 0;
				src_reg = 0;
				stack_op = 0;
				stack_dir = 0;
				dst_cpu_cfg = 0;
				dst_tmr_cfg = 0;
				src_op = 0;
			end
			8'b0000_0001: begin // Dec
				alu_op = 1;
				dst_w = 1;
			end
			8'b0000_0010: begin // Inc
				alu_op = 1;
				dst_w = 1;
			end
			8'b0000_0011: begin // Not
				alu_op = 1;
				dst_w = 1;
			end
			8'b0000_0100: begin // SetC
				alu_op = 1;
				dst_f = 1;
			end
			8'b0000_0101: begin // ClrC
				alu_op = 1;
				dst_f = 1;
			end
			8'b0000_0110: begin // RL
				alu_op = 1;
				dst_w = 1;
			end
			8'b0000_0111: begin // RR
				alu_op = 1;
				dst_w = 1;
			end
			8'b0000_1000: begin // RLC
				alu_op = 1;
				dst_w = 1;
			end
			8'b0000_1001: begin // RRC
				alu_op = 1;
				dst_w = 1;
			end
			8'b0000_1010: begin // Swap
				alu_op = 1;
				dst_w = 1;
			end
			// 8'b0000_1011: begin
			// end
			// 8'b0000_1100: begin
			// end
			// 8'b0000_1101: begin
			// end
			// 8'b0000_1110: begin
			// end
			// 8'b0000_1111: begin
			// end
			// 8'b0001_0000: begin
			// end
			// 8'b0001_0001: begin
			// end
			// 8'b0001_0010: begin
			// end
			// 8'b0001_0011: begin
			// end
			// 8'b0001_0100: begin
			// end
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
				jmp_condition = 0;
				mov_op = 0;
				dst_w = 0;
				dst_f = 0;
				dst_memory = 0;
				dst_reg = 0;
				dst_por = 0;
				dst_index = 0;
				ram_op = 0;
				dup_w = 0;
				src_port = 0;
				src_reg = 0;
				stack_op = 0;
				stack_dir = 0;
				dst_cpu_cfg = 0;
				dst_tmr_cfg = 0;
				src_op = 0;
			end
		endcase
	end

endmodule
