dsatizabal/cpuy/(commit log)

2023-11-23 Added instructions datasheet
    [Processor instructions set.xlsx]
2023-12-10 WIP: Updated with hardening changes and added readme
    [Processor instructions set.xlsx]
2025-09-26 feat: add caravel_board files and reorganize directory structure
    [Caravel_BOM.xlsx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]
